andertei/Masteroppgave/README.md

Masteroppgave
=============

Masteroppgave for Anders Teigset
