andertei/Masteroppgave/CAD bilder/Ræl.odp

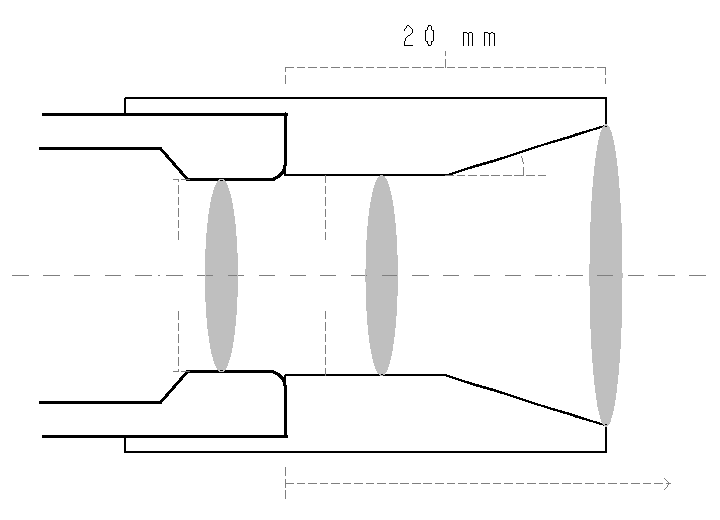
[picture p76: figure]
