andertei/Masteroppgave/Nyttige pdf-filer/kaldLuftSim.pdf

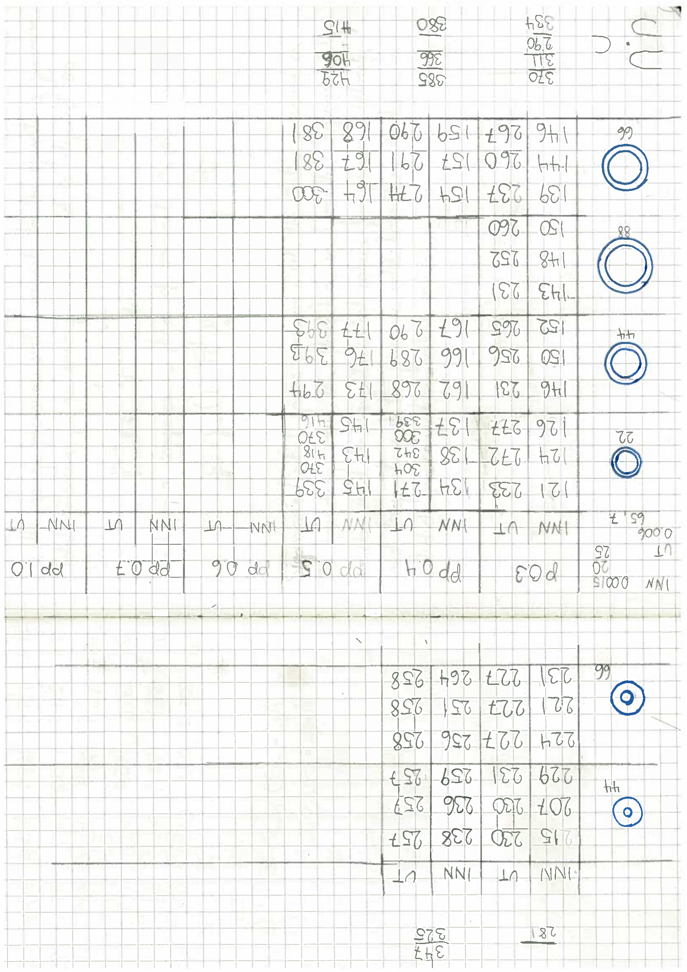
[picture p77: page 1]
