andertei/Masteroppgave/Bildesekvenser/selfblast/446_d6_579.png

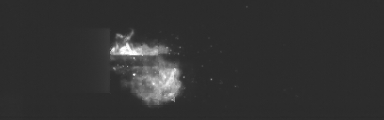
Bildesekvenser/selfblast/446_d6_579.png
