andertei/Masteroppgave/Bildesekvenser/selfblast/446_d6_580.png

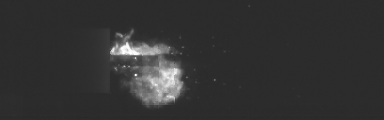
Bildesekvenser/selfblast/446_d6_580.png
