andertei/Masteroppgave/Bildesekvenser/selfblast/446_d6_589.png

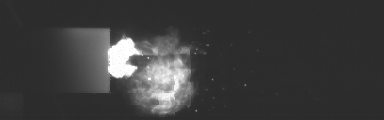
Bildesekvenser/selfblast/446_d6_589.png
