andertei/Masteroppgave/Bildesekvenser/selfblast/446_d6_592.png

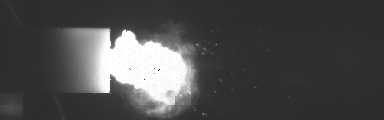
Bildesekvenser/selfblast/446_d6_592.png
