andertei/Masteroppgave/Bildesekvenser/selfblast/446_d6_594.png

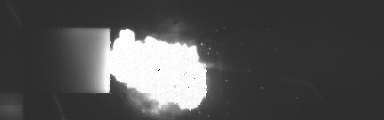
Bildesekvenser/selfblast/446_d6_594.png
