andertei/Masteroppgave/Bildesekvenser/selfblast/446_d6_596.png

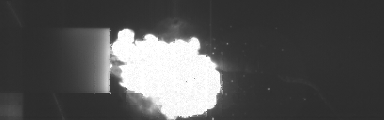
Bildesekvenser/selfblast/446_d6_596.png
