andertei/Masteroppgave/Bildesekvenser/selfblast/446_d6_607.png

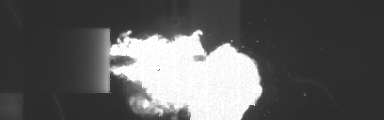
Bildesekvenser/selfblast/446_d6_607.png
