andertei/Masteroppgave/Bildesekvenser/selfblast/446_d6_608.png

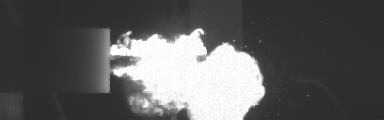
Bildesekvenser/selfblast/446_d6_608.png
