andertei/Masteroppgave/Bildesekvenser/selfblast/446_d6_611.png

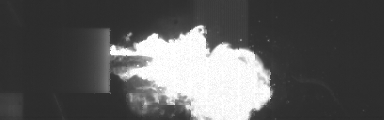
Bildesekvenser/selfblast/446_d6_611.png
