andertei/Masteroppgave/Bildesekvenser/selfblast/446_d6_622.png

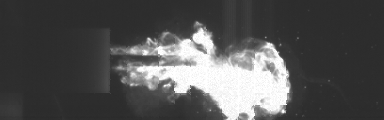
Bildesekvenser/selfblast/446_d6_622.png
