andertei/Masteroppgave/Bildesekvenser/selfblast/446_d6_626.png

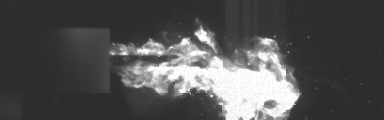
Bildesekvenser/selfblast/446_d6_626.png
