andertei/Masteroppgave/Bildesekvenser/selfblast/446_d6_628.png

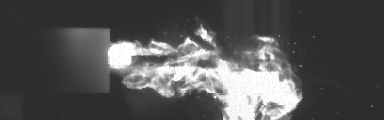
Bildesekvenser/selfblast/446_d6_628.png
