andertei/Masteroppgave/Bildesekvenser/selfblast/446_d6_629.png

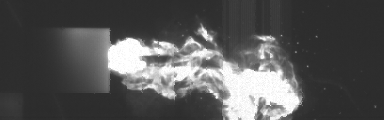
Bildesekvenser/selfblast/446_d6_629.png
