andertei/Masteroppgave/Bildesekvenser/selfblast/446_d6_630.png

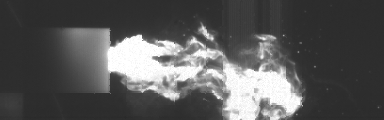
Bildesekvenser/selfblast/446_d6_630.png
