andertei/Masteroppgave/Bildesekvenser/selfblast/446_d6_632.png

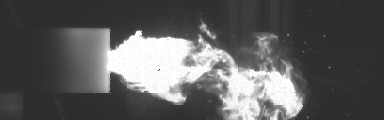
Bildesekvenser/selfblast/446_d6_632.png
