andertei/Masteroppgave/Bildesekvenser/selfblast/446_d6_634.png

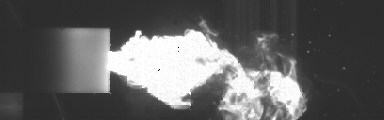
Bildesekvenser/selfblast/446_d6_634.png
