andertei/Masteroppgave/Bildesekvenser/selfblast/446_d6_635.png

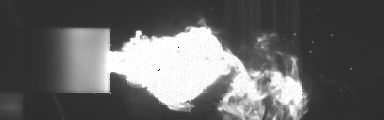
Bildesekvenser/selfblast/446_d6_635.png
