andertei/Masteroppgave/Bildesekvenser/selfblast/446_d6_637.png

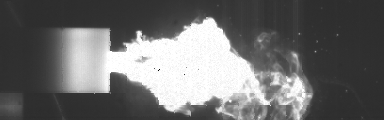
Bildesekvenser/selfblast/446_d6_637.png
