andertei/Masteroppgave/Bildesekvenser/selfblast/446_d6_638.png

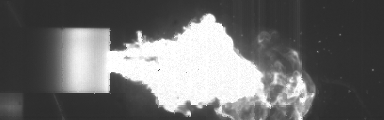
Bildesekvenser/selfblast/446_d6_638.png
