andertei/Masteroppgave/CAD bilder/ContactAndNozzleFunnelShape2.png

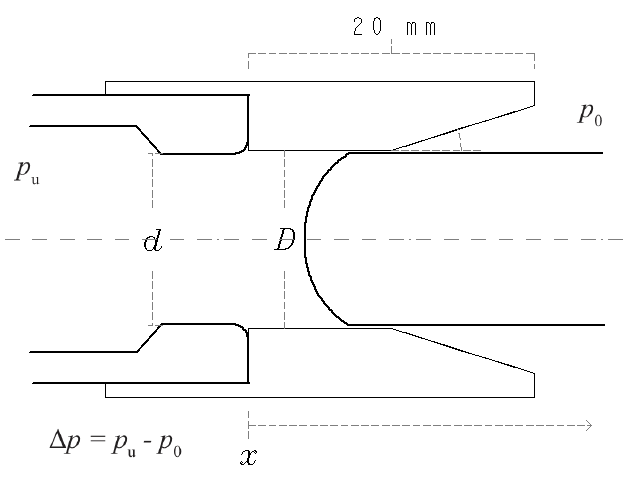
CAD bilder/ContactAndNozzleFunnelShape2.png
