andertei/Masteroppgave/CAD bilder/ContactAndNozzleFunnelShape3.png

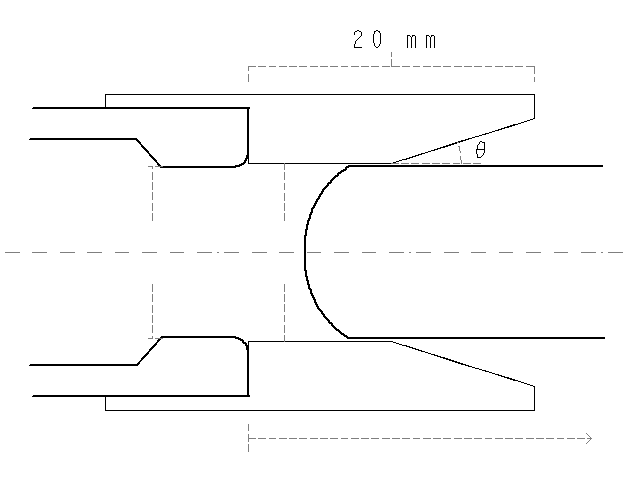
CAD bilder/ContactAndNozzleFunnelShape3.png
