andertei/Masteroppgave/CAD bilder/flowSketch/narrow_nozzle.png

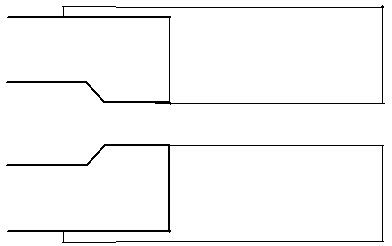
CAD bilder/flowSketch/narrow_nozzle.png
