andertei/Masteroppgave/Dokument/Bilder/Discussion/Breakdown_voltage.png

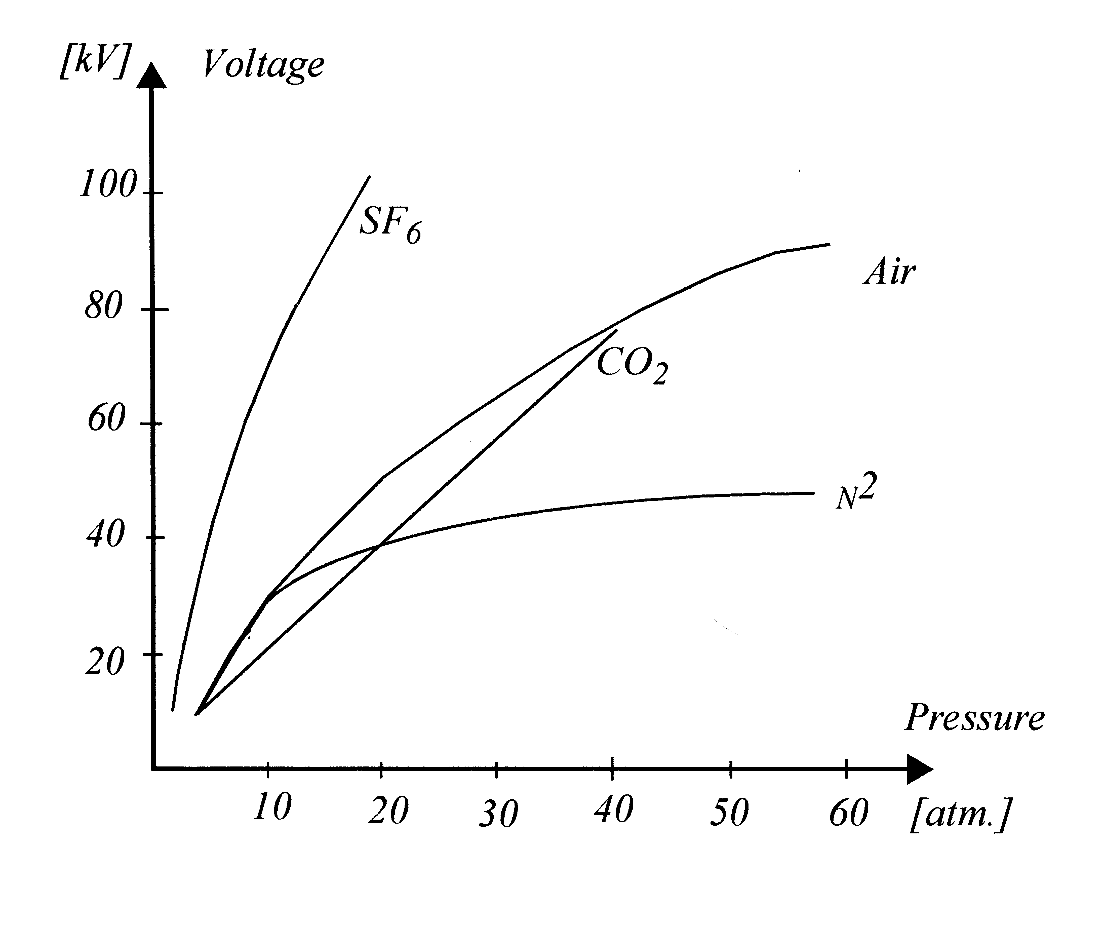
Dokument/Bilder/Discussion/Breakdown_voltage.png
