andertei/Masteroppgave/Dokument/Bilder/Discussion/conductSF6AndAIR.png

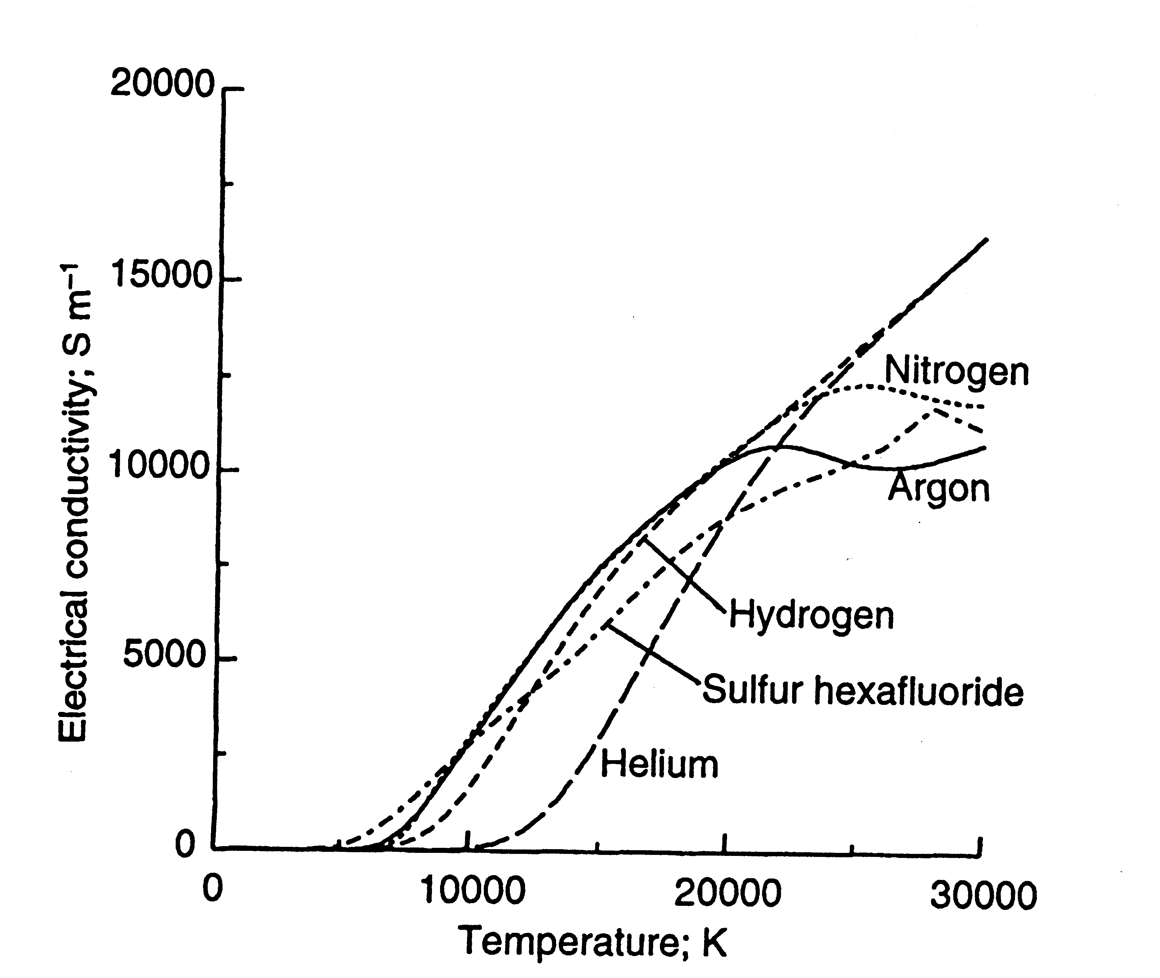
Dokument/Bilder/Discussion/conductSF6AndAIR.png
