andertei/Masteroppgave/Dokument/Bilder/Discussion/cone_D14.png

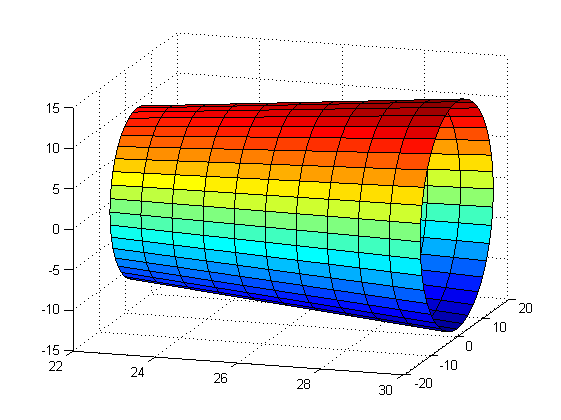
Dokument/Bilder/Discussion/cone_D14.png
