andertei/Masteroppgave/Dokument/Bilder/Discussion/cone_D16.png

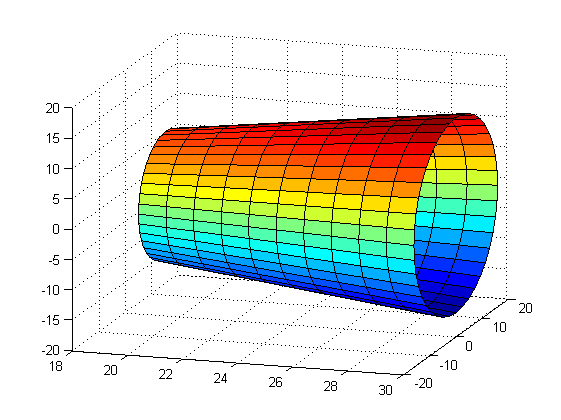
Dokument/Bilder/Discussion/cone_D16.png
