andertei/Masteroppgave/Dokument/Bilder/Discussion/d3_630_burn.png

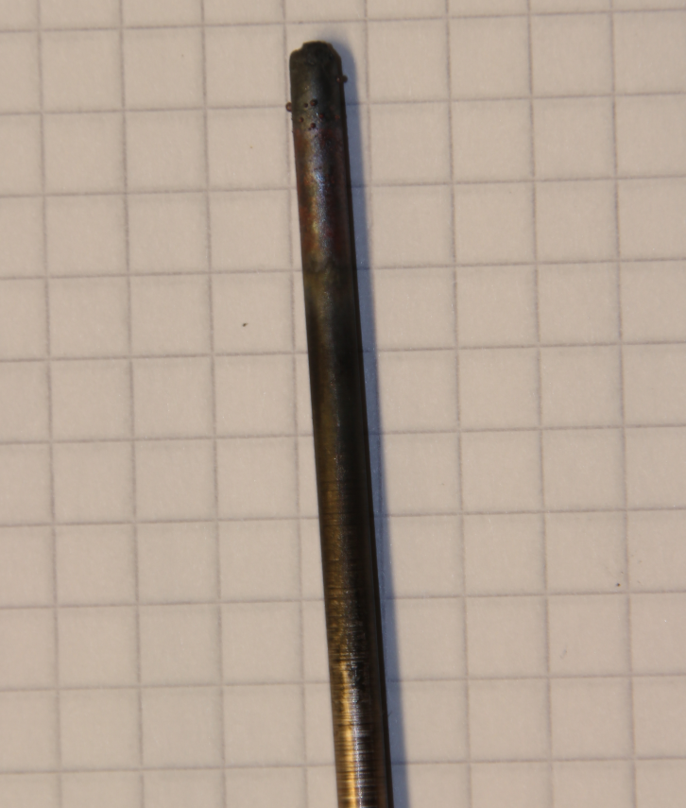
Dokument/Bilder/Discussion/d3_630_burn.png
