andertei/Masteroppgave/Dokument/Bilder/Discussion/d3_630_top_burn.png

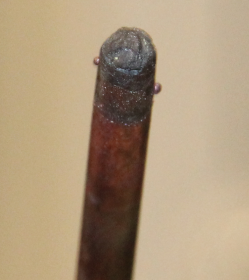
Dokument/Bilder/Discussion/d3_630_top_burn.png
