andertei/Masteroppgave/Dokument/Bilder/Discussion/d4_630and400_burn.png

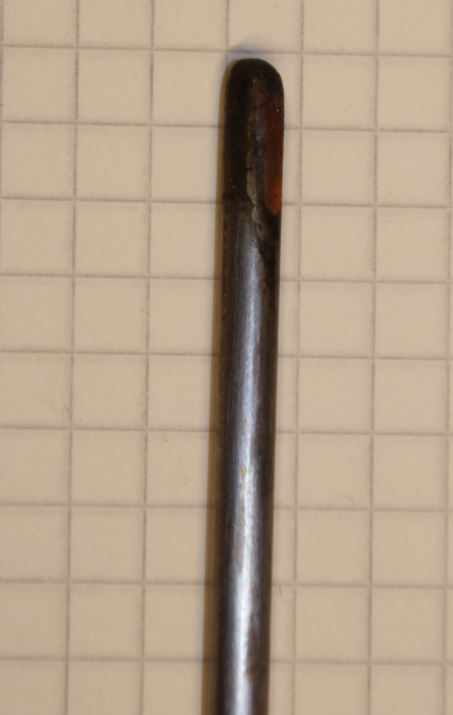
Dokument/Bilder/Discussion/d4_630and400_burn.png
