andertei/Masteroppgave/Dokument/Bilder/Discussion/d4_630and400_top_burn.png

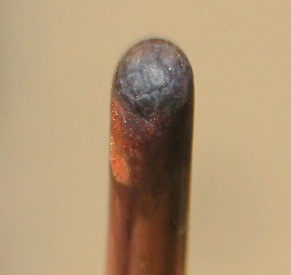
Dokument/Bilder/Discussion/d4_630and400_top_burn.png
