andertei/Masteroppgave/Dokument/Bilder/Discussion/femaleContacts4mmand3mm.png

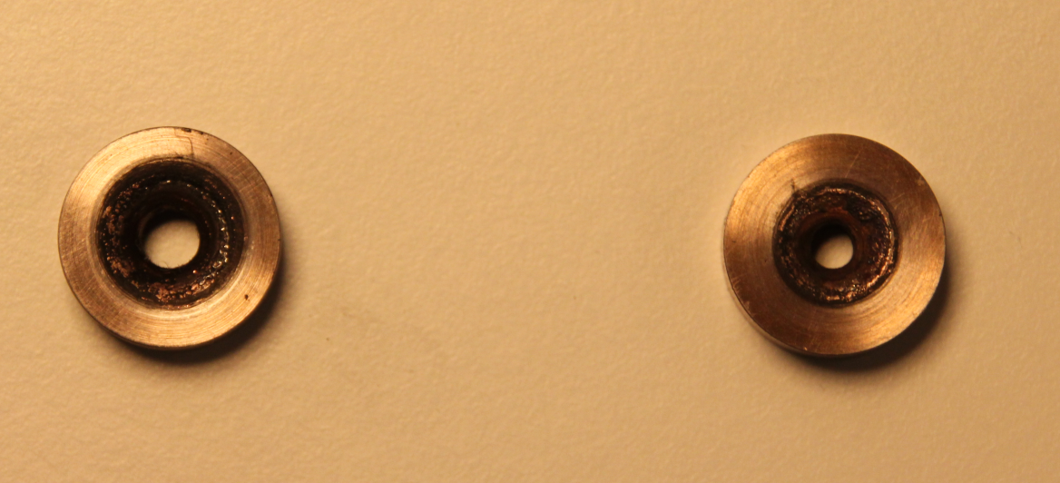
Dokument/Bilder/Discussion/femaleContacts4mmand3mm.png
