andertei/Masteroppgave/Dokument/Bilder/Discussion/paraDefine.png

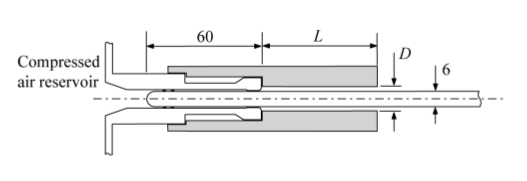
Dokument/Bilder/Discussion/paraDefine.png
