andertei/Masteroppgave/Dokument/Bilder/Discussion/percentSuccMVLBS.png

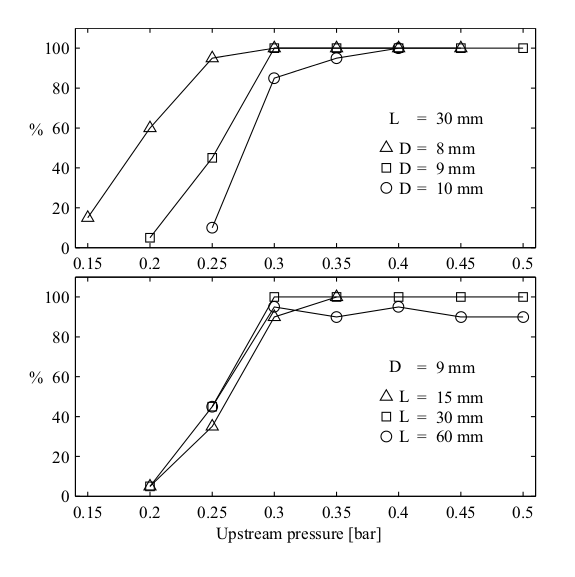
Dokument/Bilder/Discussion/percentSuccMVLBS.png
