andertei/Masteroppgave/Dokument/Bilder/Method/areaSetUp.png

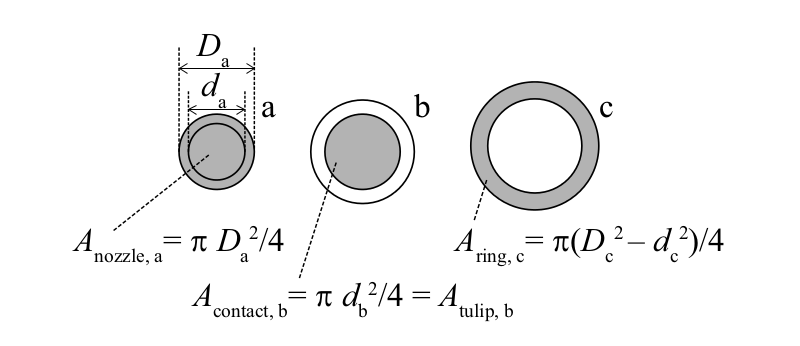
Dokument/Bilder/Method/areaSetUp.png
