andertei/Masteroppgave/Dokument/Bilder/Method/contactSetUpVmax2.png

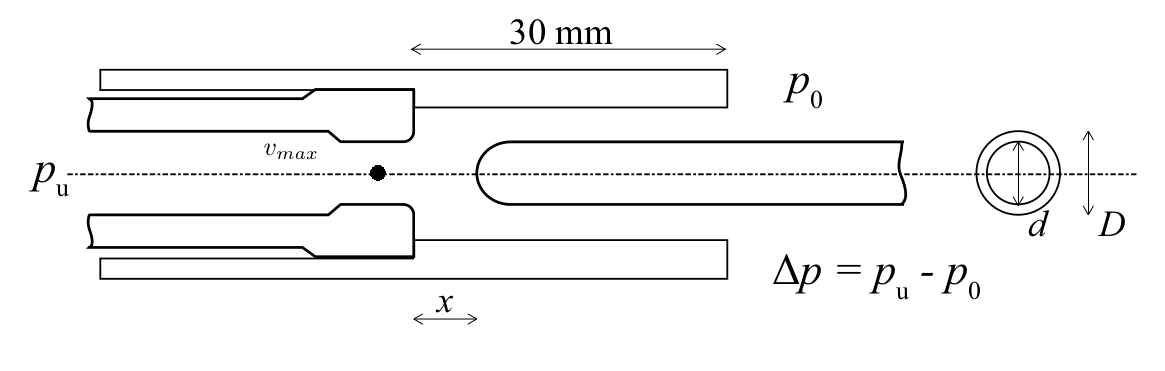
Dokument/Bilder/Method/contactSetUpVmax2.png
