andertei/Masteroppgave/Dokument/Bilder/Method/contactSetUpVmax3.png

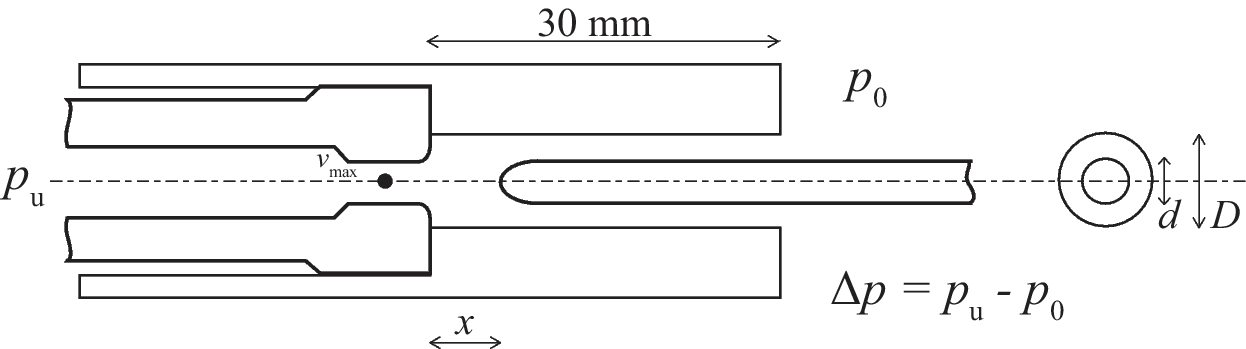
Dokument/Bilder/Method/contactSetUpVmax3.png
