andertei/Masteroppgave/Dokument/Bilder/Theory/arcingVoltagevzCurrent.png

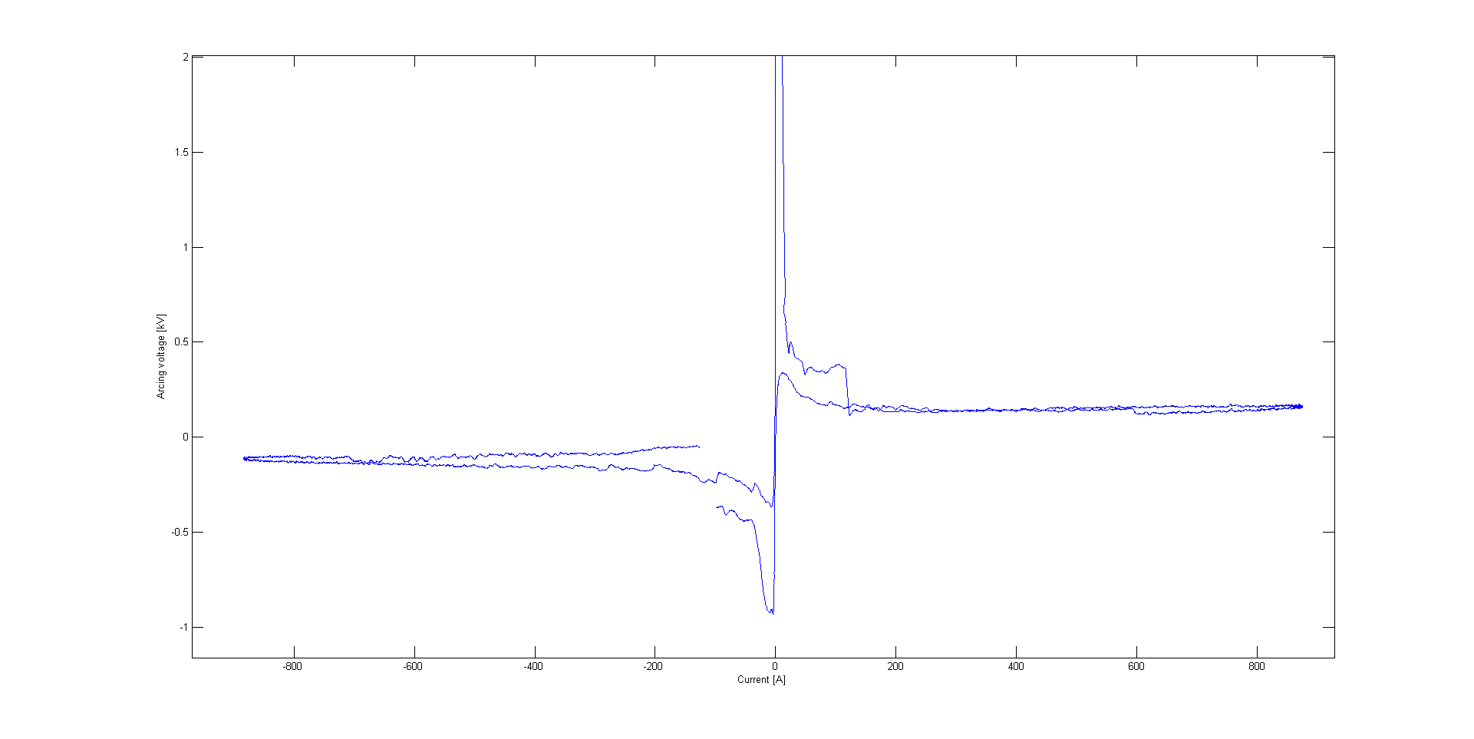
Dokument/Bilder/Theory/arcingVoltagevzCurrent.png
