andertei/Masteroppgave/Dokument/Bilder/Theory/CircutBreakPuff2.png

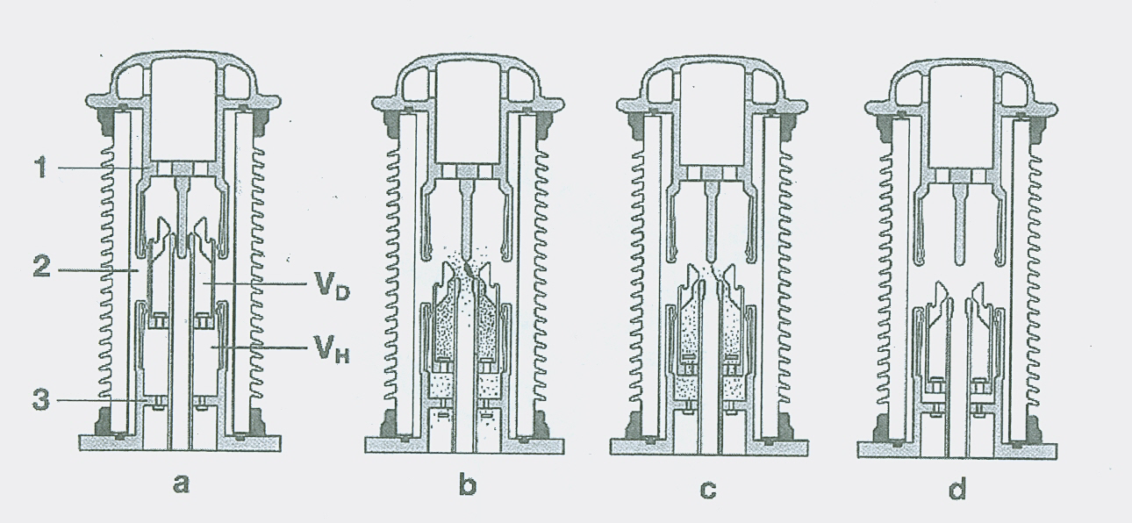
Dokument/Bilder/Theory/CircutBreakPuff2.png
