andertei/Masteroppgave/Dokument/Bilder/Theory/consentrationSF6.png

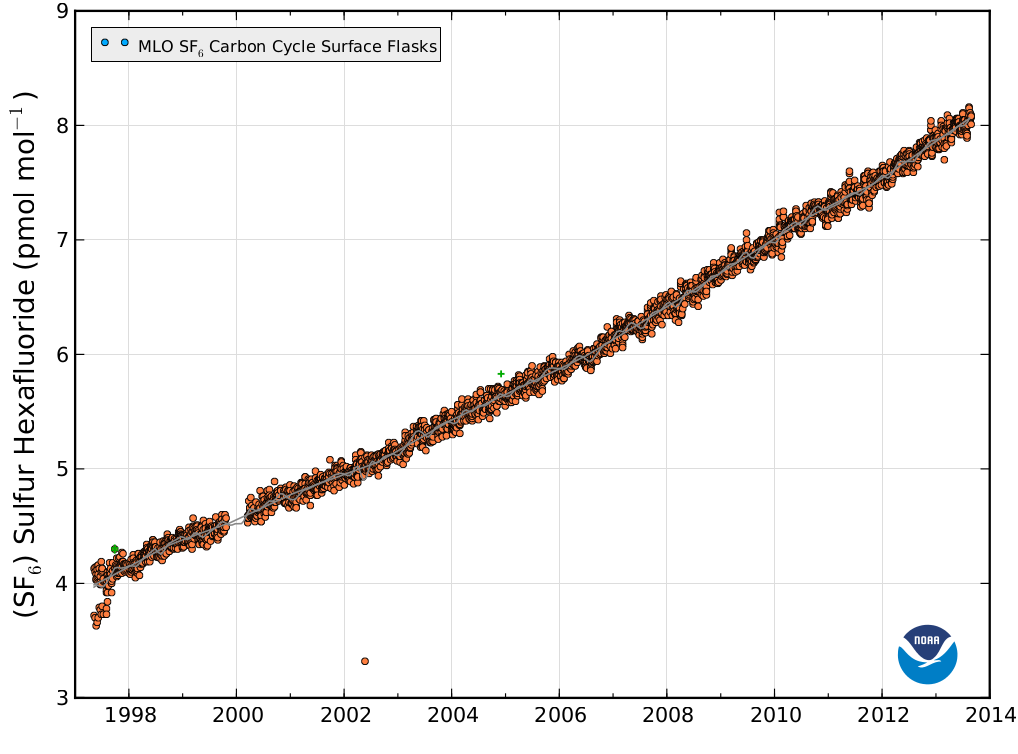
Dokument/Bilder/Theory/consentrationSF6.png
