andertei/Masteroppgave/Dokument/Bilder/Theory/differentGeometries.png

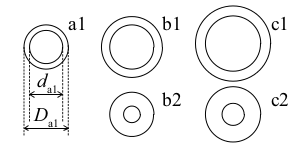
Dokument/Bilder/Theory/differentGeometries.png
