andertei/Masteroppgave/Dokument/Bilder/Theory/diffFreq2.png

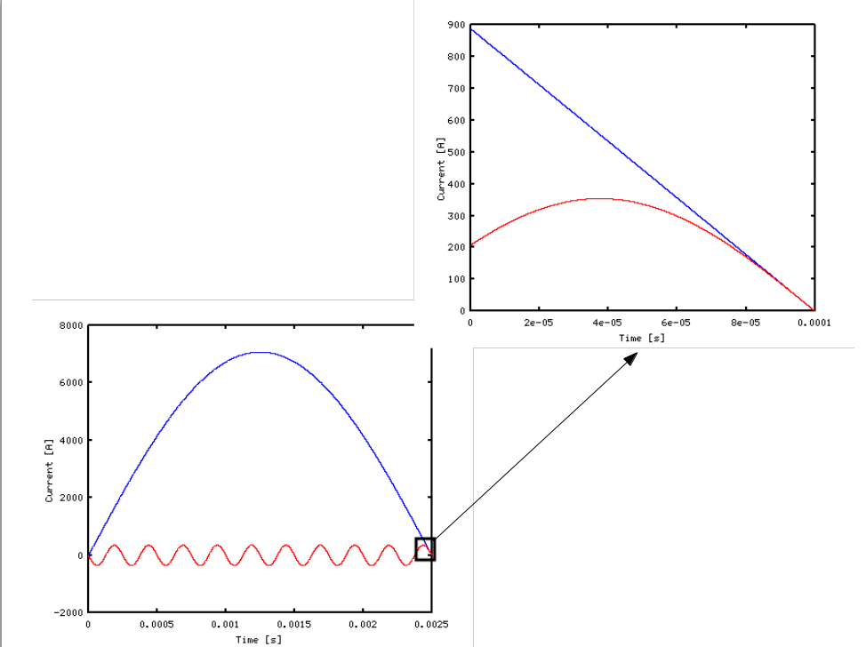
Dokument/Bilder/Theory/diffFreq2.png
