andertei/Masteroppgave/Dokument/Bilder/Theory/diffFreq.png

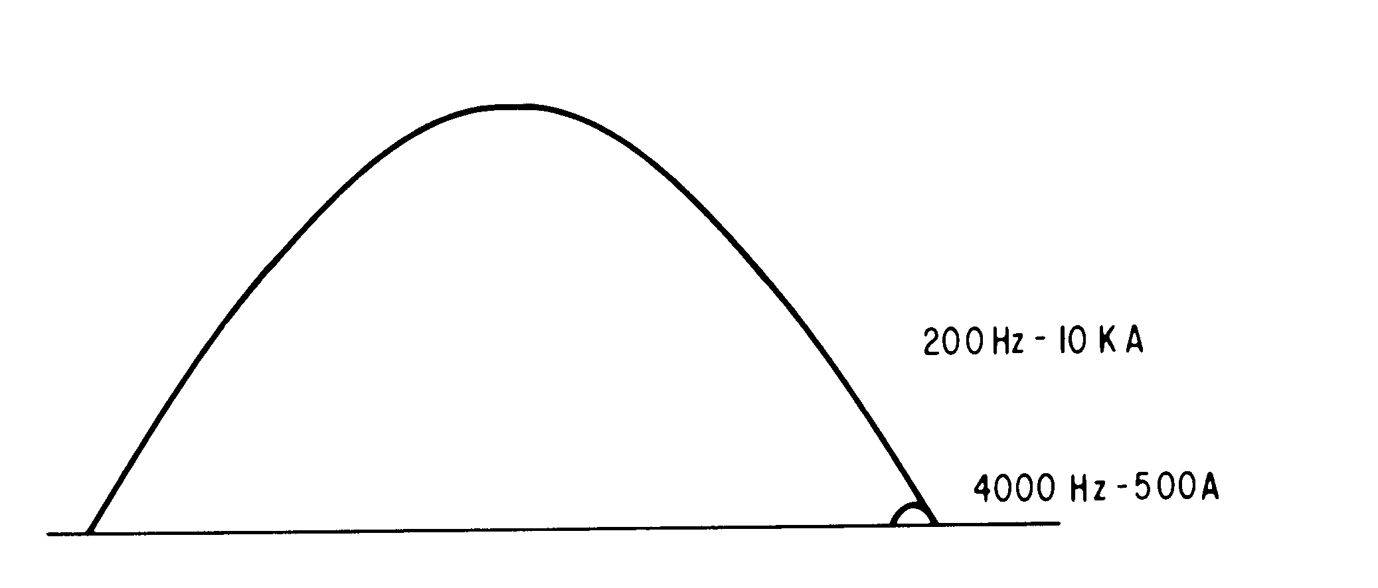
Dokument/Bilder/Theory/diffFreq.png
