andertei/Masteroppgave/Dokument/Bilder/Theory/emissionsSF6Norway.png

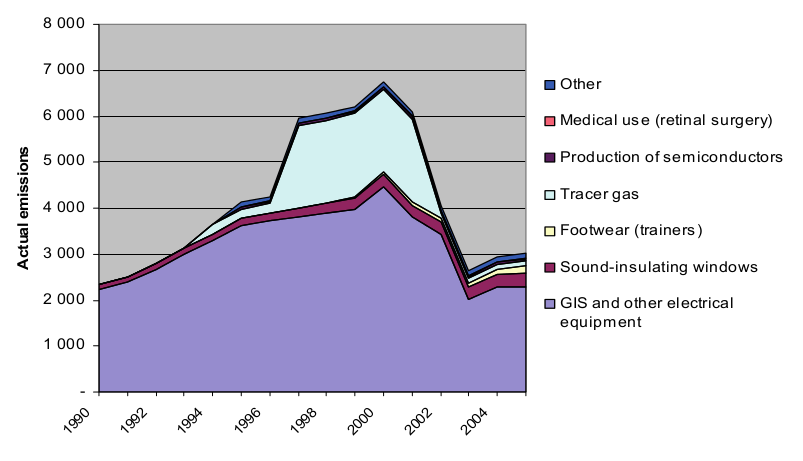
Dokument/Bilder/Theory/emissionsSF6Norway.png
