andertei/Masteroppgave/Dokument/Bilder/Theory/freq1.png

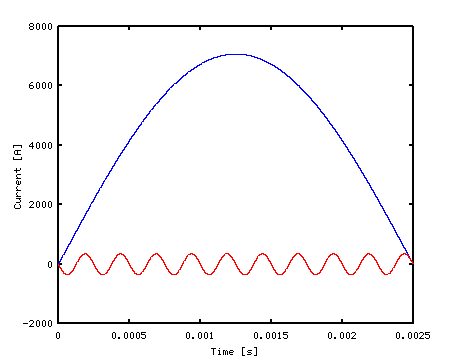
Dokument/Bilder/Theory/freq1.png
