andertei/Masteroppgave/Dokument/Bilder/Theory/freq2.png

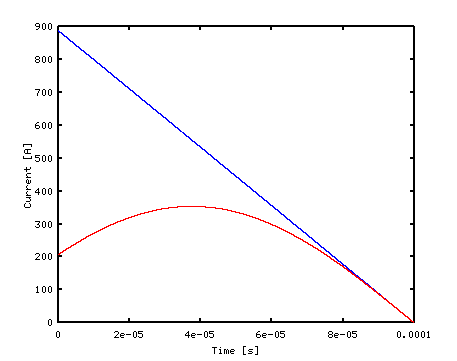
Dokument/Bilder/Theory/freq2.png
