andertei/Masteroppgave/Dokument/Bilder/Theory/freq3.png

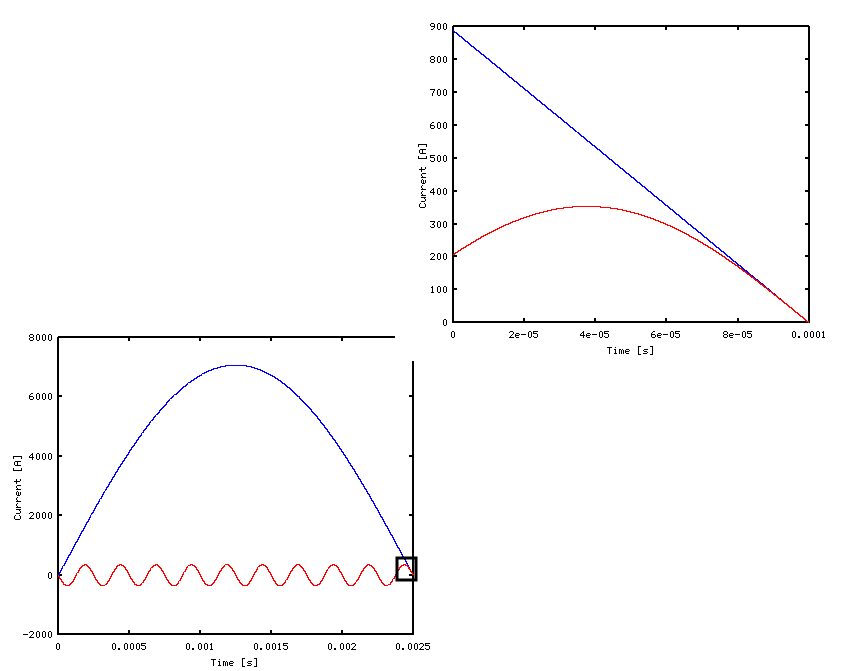
Dokument/Bilder/Theory/freq3.png
