andertei/Masteroppgave/Dokument/Bilder/Theory/kontaktoversiktAnders.png

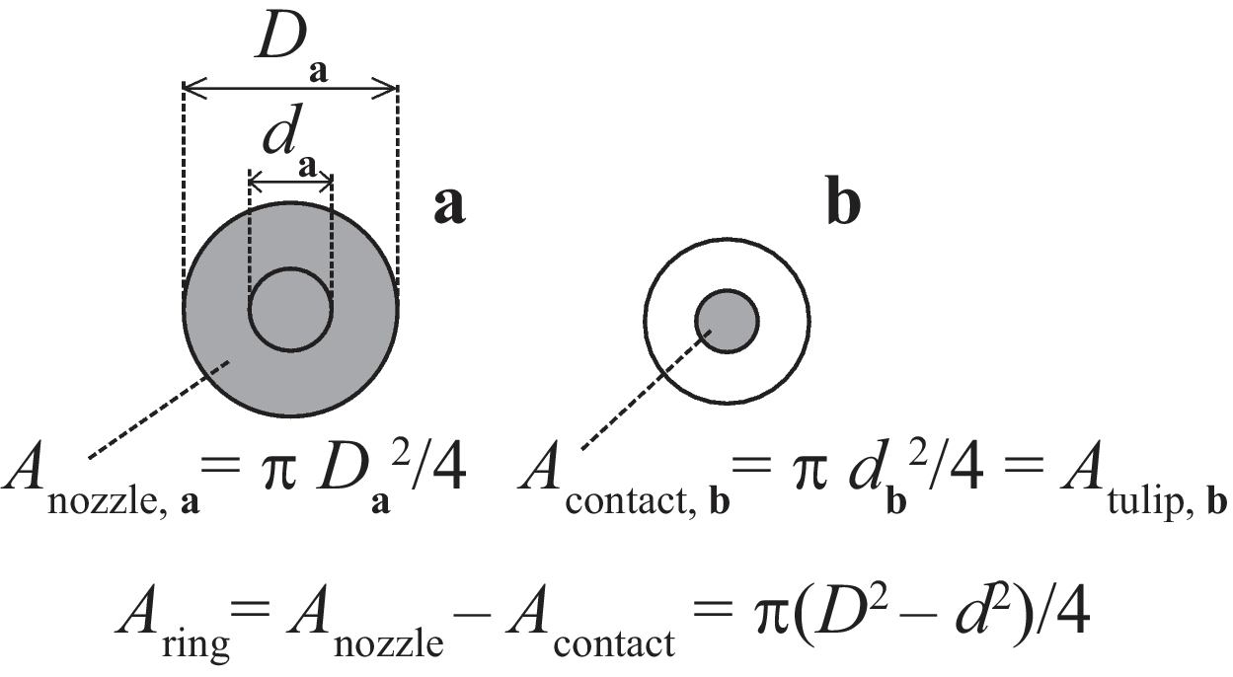
Dokument/Bilder/Theory/kontaktoversiktAnders.png
