andertei/Masteroppgave/Dokument/Bilder/Theory/particleDensSF6.png

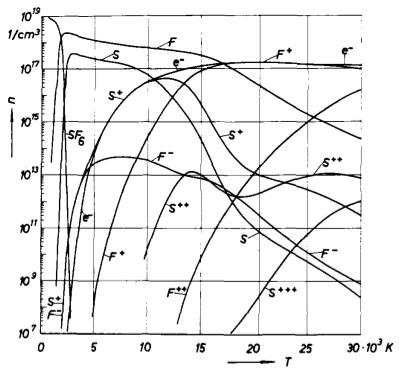
Dokument/Bilder/Theory/particleDensSF6.png
