andertei/Masteroppgave/Dokument/Bilder/Theory/SF6Conduct.png

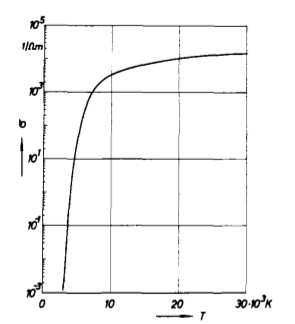
Dokument/Bilder/Theory/SF6Conduct.png
