andertei/Masteroppgave/CAD bilder/#contactGeometry_areaDeff.dxf

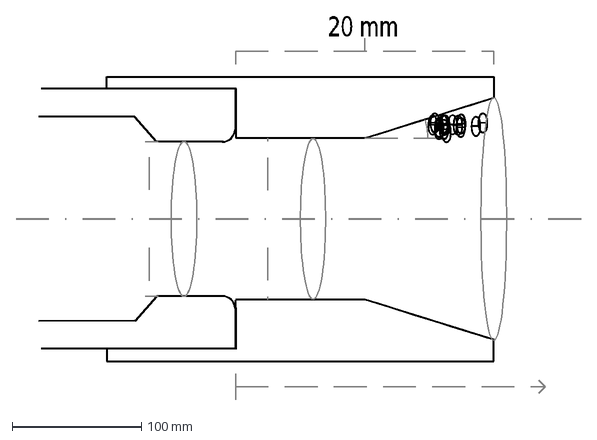
[picture p127: CAD file, 2014-02-04]
CAD bilder/#contactGeometry_areaDeff.dxf
θ
20 mm
