andertei/Masteroppgave/CAD bilder/bellow/#bellow.dxf

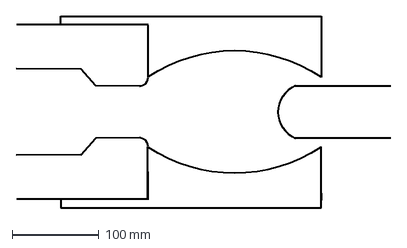
[picture p128: CAD file, 2014-04-25]
CAD bilder/bellow/#bellow.dxf
431.6 x 220.7 mm
