andertei/Masteroppgave/CAD bilder/flowSketch/flowSketch_wide.dxf

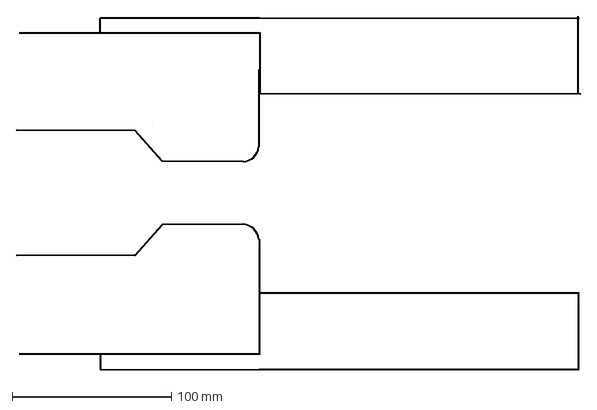
[picture p129: CAD file, 2014-04-24]
CAD bilder/flowSketch/flowSketch_wide.dxf
354.3 x 221.6 mm
