andertei/Masteroppgave/CAD bilder/contactGeometry2.dxf

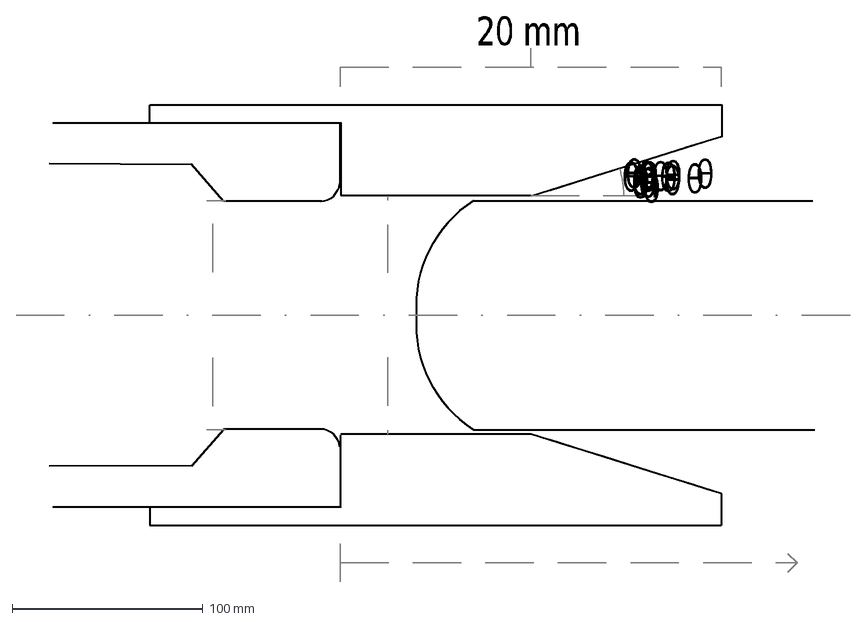
[picture p130: CAD file, 2014-02-03]
CAD bilder/contactGeometry2.dxf
θ
20 mm
q
