andertei/Masteroppgave/CAD bilder/flowSketch/flowSketch_narrow.dxf

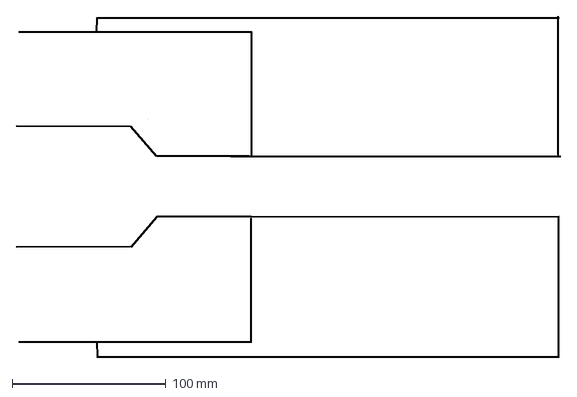
[picture p131: CAD file, 2014-04-24]
CAD bilder/flowSketch/flowSketch_narrow.dxf
354.3 x 221.6 mm
