andertei/Masteroppgave/CAD bilder/##contactGeometry.dxf

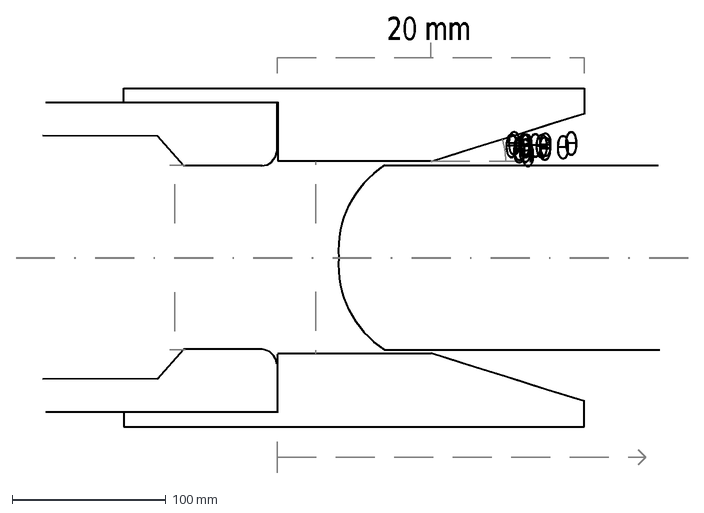
[picture p132: CAD file, 2014-02-03]
CAD bilder/##contactGeometry.dxf
θ
20 mm
q
