andertei/Masteroppgave/CAD bilder/flowSketch/#flowSketch.dxf

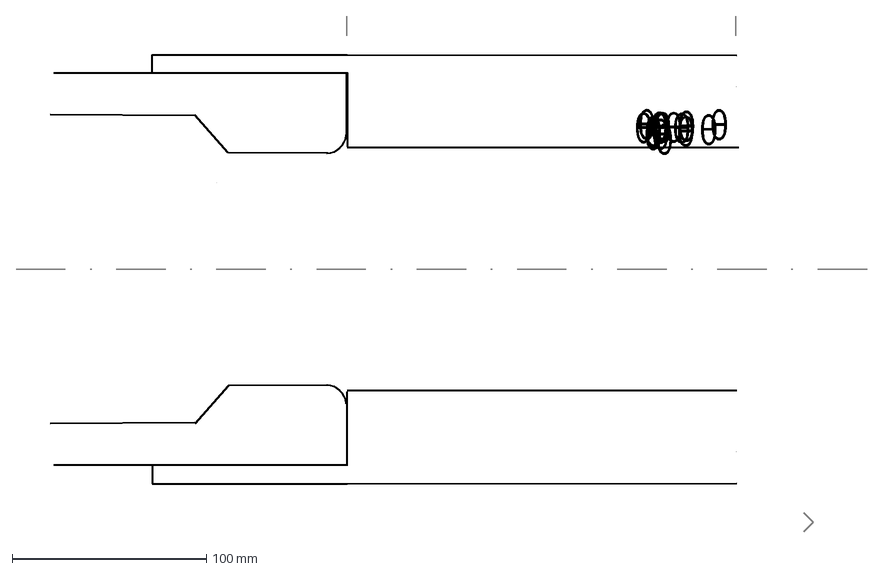
[picture p133: CAD file, 2014-04-24]
CAD bilder/flowSketch/#flowSketch.dxf
θ
