andertei/Masteroppgave/(list of files, cad)

Other CAD files:
CAD bilder/#contactGeometry.dxf
CAD bilder/bellow/bellow.dxf
CAD bilder/contactGeometry_areaDeff.dxf
CAD bilder/flowSketch/flowSketch.dxf
