andertei/Masteroppgave/Resultater/excel-plot/630Ad7.1.xlsx

Sheet: 630AgeoC
Pressure | Position at first CZ | Position at secound CZ | Succsess
0.4 | 55 |  | 1
0.4 | 42 |  | 1 |  | Test less than 35 are dicarded due to transcation effects from the nozzle |  |  |  |  | Antall brytninger som gikk for 35+ for statistikk
0.4 | 47 |  | 1 |  | 630 A |  |  |  |  | 1
0.4 | 53 |  | 1 | Pressure | Amount of successful | Successrate | Number of tests | Total Succsessrate |  | 1
0.4 | 51 |  | 1 | 0.2 | 0 | 0 | 5 |  |  | 1
0.35 | 36 | 91 | 0 | 0.25 | 0 | 0 | 5 |  |  | 1
0.35 | 42 |  | 1 | 0.3 | 8 | 80 | 10 |  |  | 1
0.35 | 54 |  | 1 | 0.35 | 4 | 80 | 5 |  |  | 1
0.35 | 43 |  | 1 | 0.4 | 5 | 100 | 5 |  |  | 1
0.35 | 45 |  | 1 |  |  |  |  |  | 15 | 1
0.3 | 49 |  | 1 |  |  |  |  |  |  | 1
0.3 | 42 |  | 1 |  |  |  |  |  |  | 0
0.3 | 48 |  | 1 |  |  |  |  |  |  | 0
0.3 | 35 | 83 | 1 |  |  |  |  |  | 72 | 0
0.3 | 40 |  | 1 |  |  |  |  |  |  | 0
0.3 | 35 |  | 1 |  |  |  |  |  |  | 1
0.3 | 37 |  | 1 |  |  |  |  |  |  | 1
0.3 | 43 |  | 1 |  |  |  |  |  |  | 1
0.3 | 42 | 59 | 0 |  |  |  |  |  |  | 1
0.3 | 50 | 108 | 0 |  |  |  |  |  |  | 1
0.2 | 36 | 90 | 0 |  |  |  |  |  |  | 1
0.2 | 54 | 102 | 0 |  |  |  |  |  |  | 1
0.2 | 43 | 90 | 0 |  |  |  |  |  |  | 0
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
