andertei/Masteroppgave/Resultater/excel-plot/630Ad6.0.xlsx

Sheet: 630Adata
Pressure | Position at first CZ | Position at secound CZ | Succsess
0.3 | 39 |  | 1
0.3 | 26 |  | 1
0.3 | 19 |  | 1
0.3 | 49 |  | 1 |  | 630 A
0.3 | 21 |  | 1 | Pressure | Amount of successful | Successrate | Number of tests | Number of success funnle | Succsesrate funnle | Number of success outside | Successrate outside
0.3 | 19 |  | 1 | 0.15 | 0 | 0 | 10 | 0 | 0 | 0 | 0
0.3 | 47 |  | 1 | 0.2 | 6 | 60 | 10 | 2 | 40 | 4 | 80
0.3 | 15 |  | 1 | 0.25 | 9 | 90 | 10 | 3.97 | 79.4 | 4 | 80
0.3 | 11 |  | 1 | 0.3 | 10 | 100 | 10 | 4.97 | 99.4 | 5 | 100
0.3 | 11 |  | 1
0.25 | 26 |  | 1
0.25 | 23 |  | 1
0.25 | 16 |  | 1
0.25 | 55 |  | 1 | 20+ |  | geoA630 |  |  | 10+
0.25 | 26 | 81 | 1 | 0.3 | 1 |  |  | 0.3 | 1
0.25 | 36 |  | 1 | 0.3 | 1 |  |  | 0.3 | 1
0.25 | 15 |  | 1 | 0.3 | 1 |  |  | 0.3 | 1
0.25 | 15 | 70 | 0 | 0.3 | 1 |  |  | 0.3 | 1
0.25 | 15 |  | 1 | 0.3 | 1 |  |  | 0.3 | 1
0.25 | 17 |  | 1 | 0.3 | 1 |  |  | 0.3 | 1
0.2 | 16 | 68 | 0 | 0.3 | 1 |  |  | 0.3 | 1
0.2 | 17 |  | 1 | 0.3 | 1 |  |  | 0.3 | 1
0.2 | 14 | 69 | 0 | 0.3 | 1 |  |  | 0.3 | 1
0.2 | 11 | 65 | 0 | 0.3 | 1 | 11 |  | 0.3 | 1
0.2 | 44 |  | 1 | 0.3 | 1 | success rate= | 100 | 0.3 | 1 | antall: 18
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
