andertei/Masteroppgave/Dokument/Bilder/Discussion/ninaResults.png

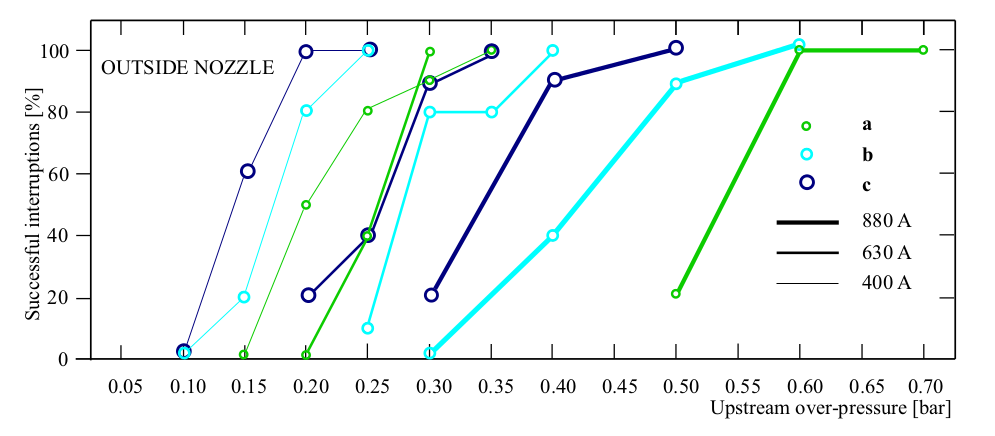
Dokument/Bilder/Discussion/ninaResults.png
