andertei/Masteroppgave/Dokument/Bilder/Discussion/testResultsNinaInside.png

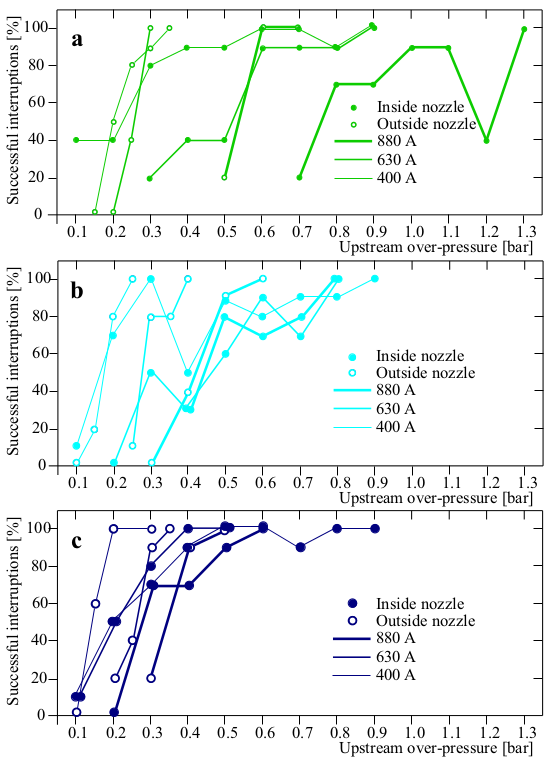
Dokument/Bilder/Discussion/testResultsNinaInside.png
