andertei/Masteroppgave/Dokument/Bilder/Results/arcingVoltage400Ad4.png

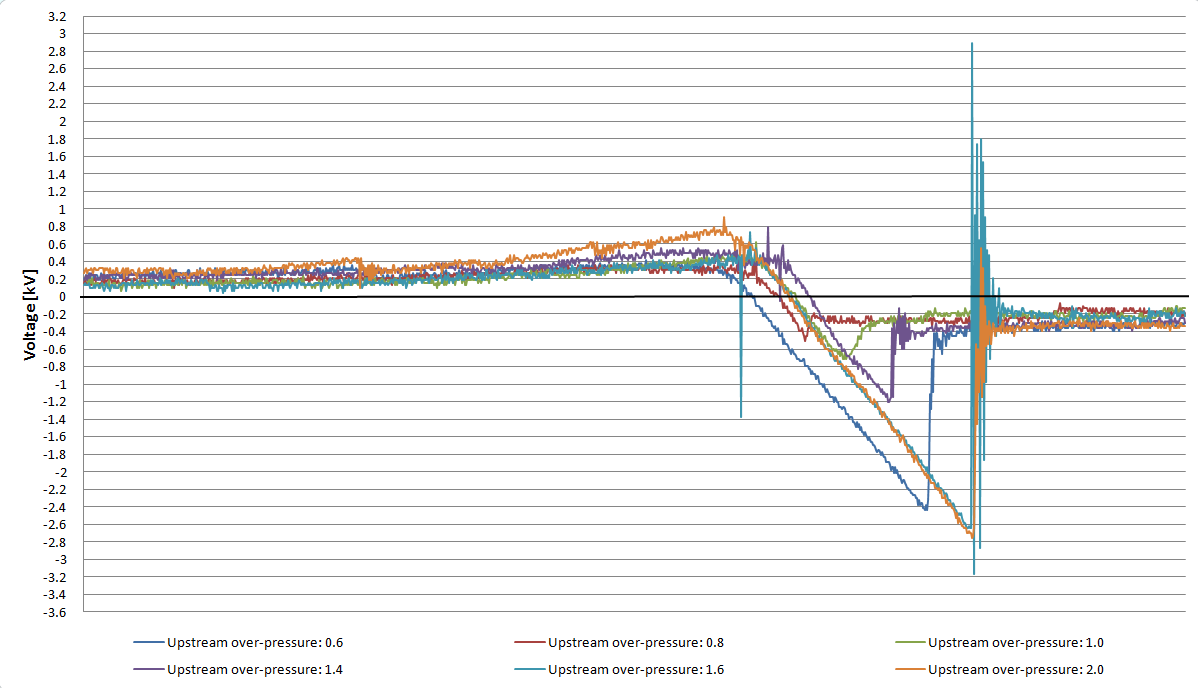
Dokument/Bilder/Results/arcingVoltage400Ad4.png
