andertei/Masteroppgave/Dokument/Bilder/Results/arcingVoltage630Ad4.png

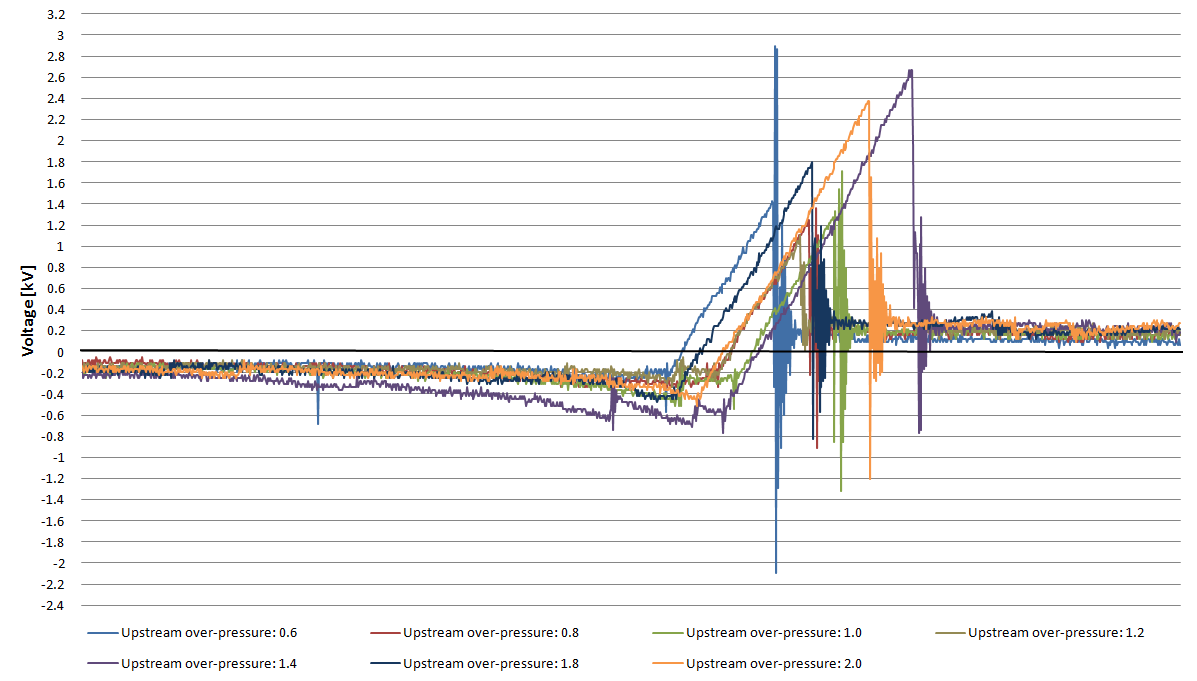
Dokument/Bilder/Results/arcingVoltage630Ad4.png
