andertei/Masteroppgave/Dokument/Bilder/Results/ATPdraw_lab.png

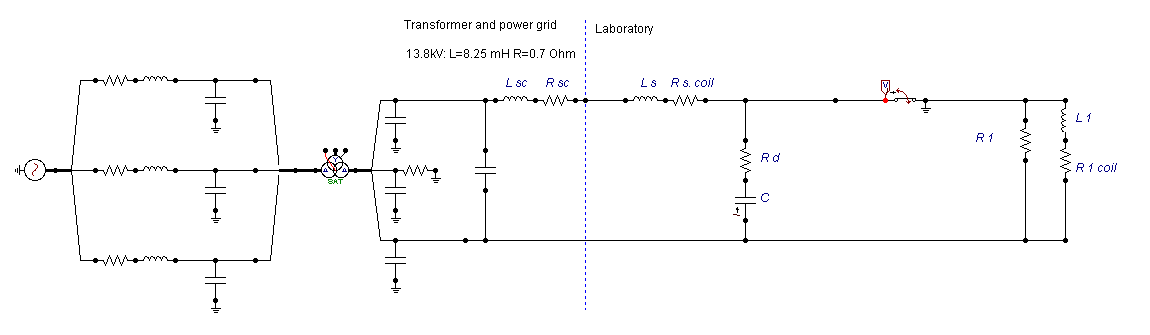
Dokument/Bilder/Results/ATPdraw_lab.png
