andertei/Masteroppgave/Dokument/Bilder/Results/ATPdraw_lab_2.png

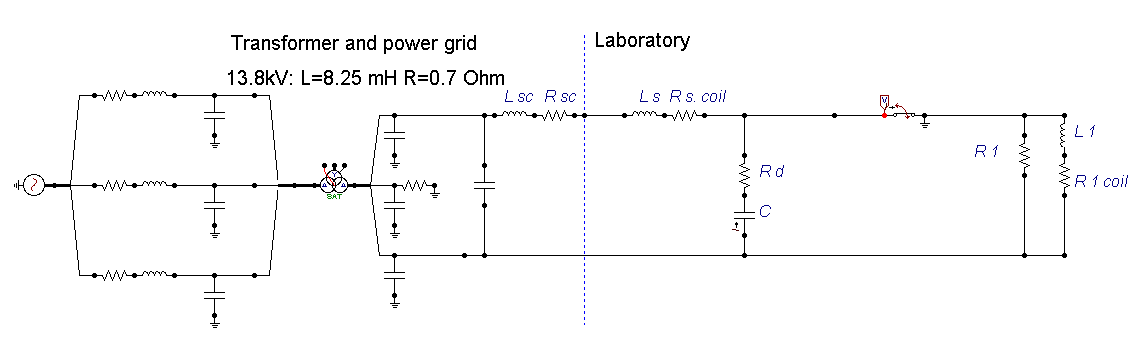
Dokument/Bilder/Results/ATPdraw_lab_2.png
