andertei/Masteroppgave/Dokument/Bilder/Results/ATPdraw_Over_CurrentandVoltage.png

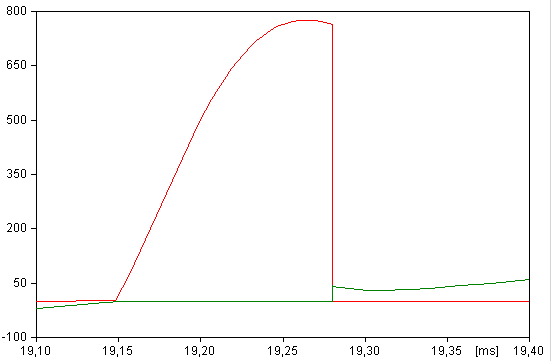
Dokument/Bilder/Results/ATPdraw_Over_CurrentandVoltage.png
