andertei/Masteroppgave/Dokument/Bilder/Results/ATPdraw_Over_CurrentandVoltage_2.png

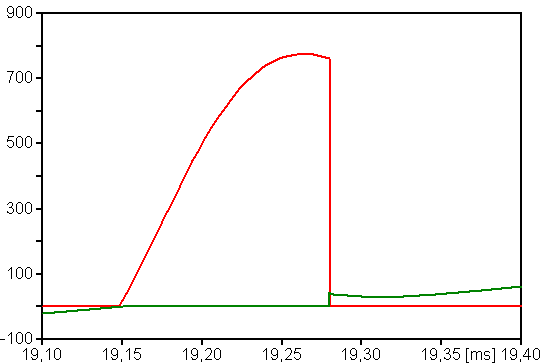
Dokument/Bilder/Results/ATPdraw_Over_CurrentandVoltage_2.png
