andertei/Masteroppgave/Dokument/Bilder/Results/ATPdraw_Over_CurrentandVoltage_label.png

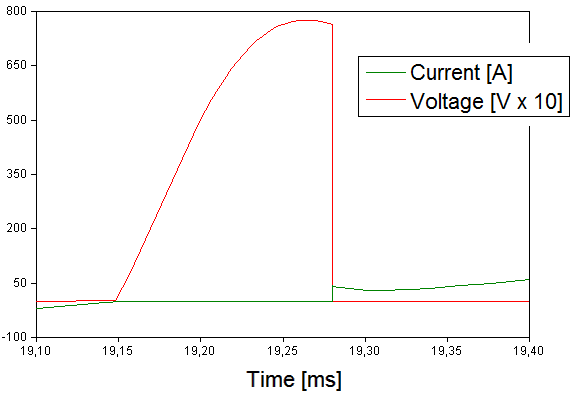
Dokument/Bilder/Results/ATPdraw_Over_CurrentandVoltage_label.png
