andertei/Masteroppgave/Dokument/Bilder/Results/ATPdraw_ZOOM_CurrentandVoltage.png

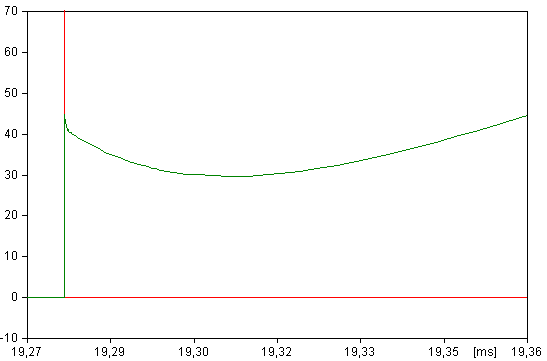
Dokument/Bilder/Results/ATPdraw_ZOOM_CurrentandVoltage.png
