andertei/Masteroppgave/Dokument/Bilder/Results/ATPdraw_ZOOM_CurrentandVoltage_2.png

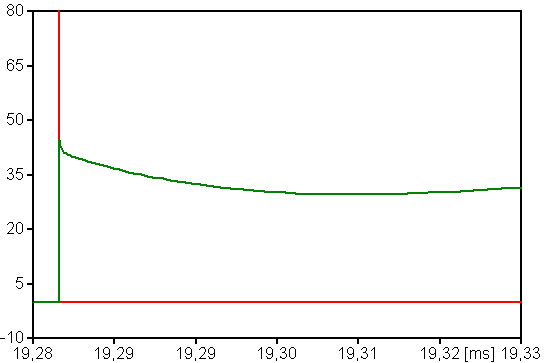
Dokument/Bilder/Results/ATPdraw_ZOOM_CurrentandVoltage_2.png
