andertei/Masteroppgave/Dokument/Bilder/Results/ATPdraw_ZOOM_CurrentandVoltage_label.png

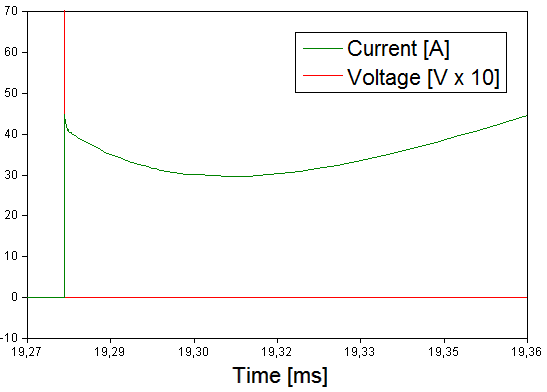
Dokument/Bilder/Results/ATPdraw_ZOOM_CurrentandVoltage_label.png
