andertei/Masteroppgave/Dokument/Bilder/Results/bellow1.png

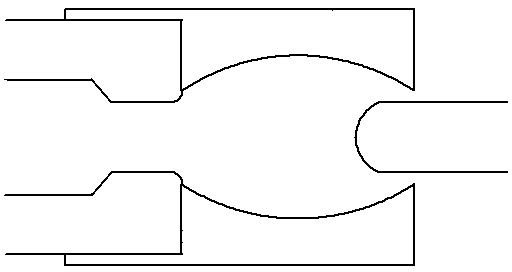
Dokument/Bilder/Results/bellow1.png
