andertei/Masteroppgave/Dokument/Bilder/Results/bellow.png

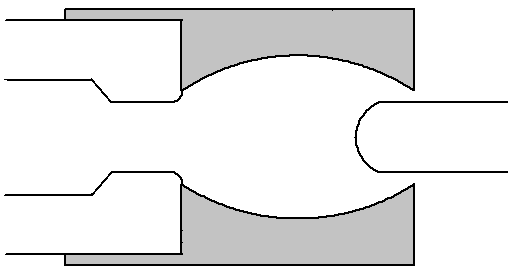
Dokument/Bilder/Results/bellow.png
