andertei/Masteroppgave/Dokument/Bilder/Results/compAllCylin.PNG

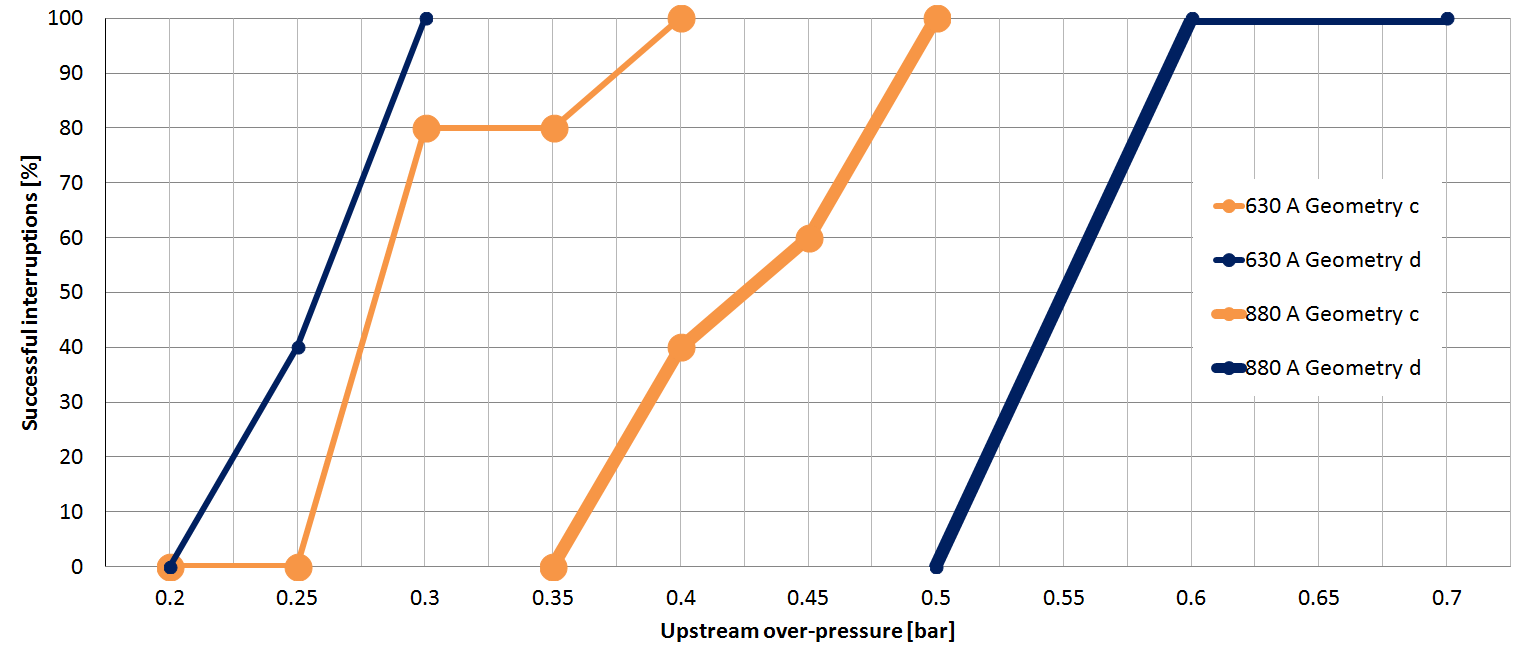
Dokument/Bilder/Results/compAllCylin.PNG
