andertei/Masteroppgave/Dokument/Bilder/Results/compAllFunnel.PNG

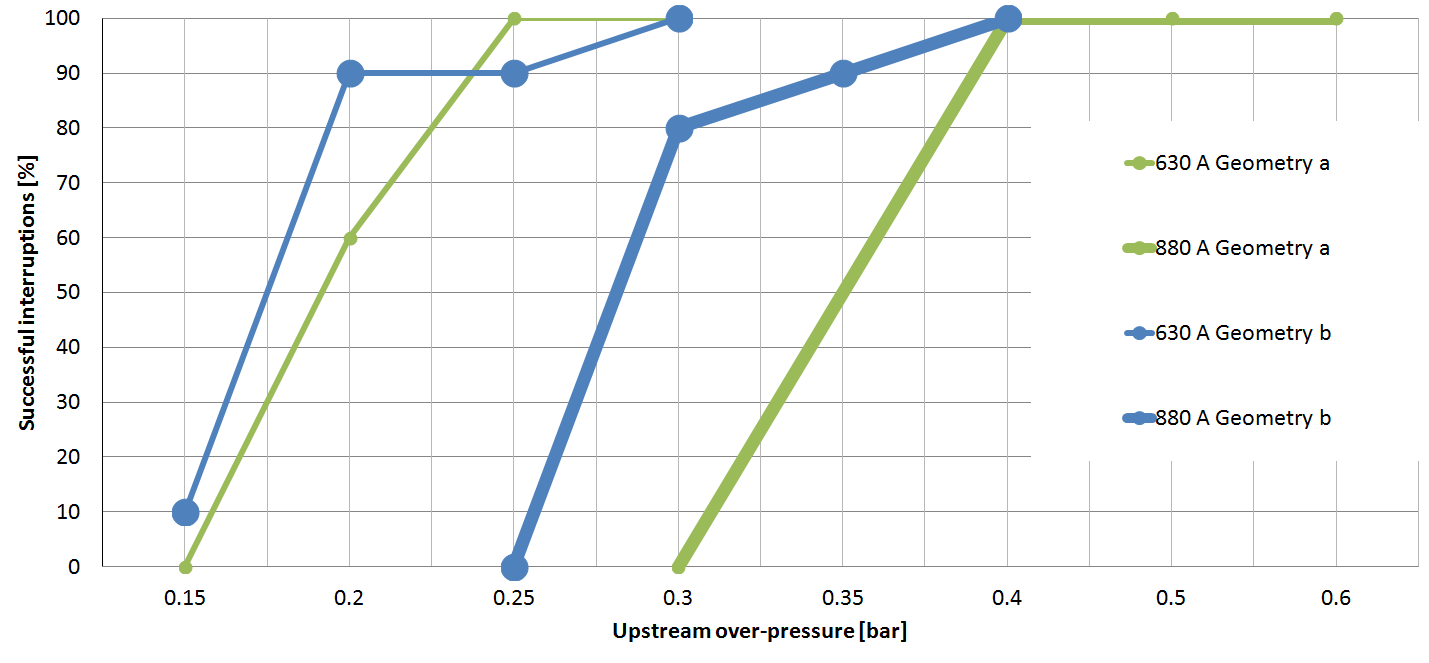
Dokument/Bilder/Results/compAllFunnel.PNG
