andertei/Masteroppgave/Dokument/Bilder/Results/compAllFunnel_riktig.PNG

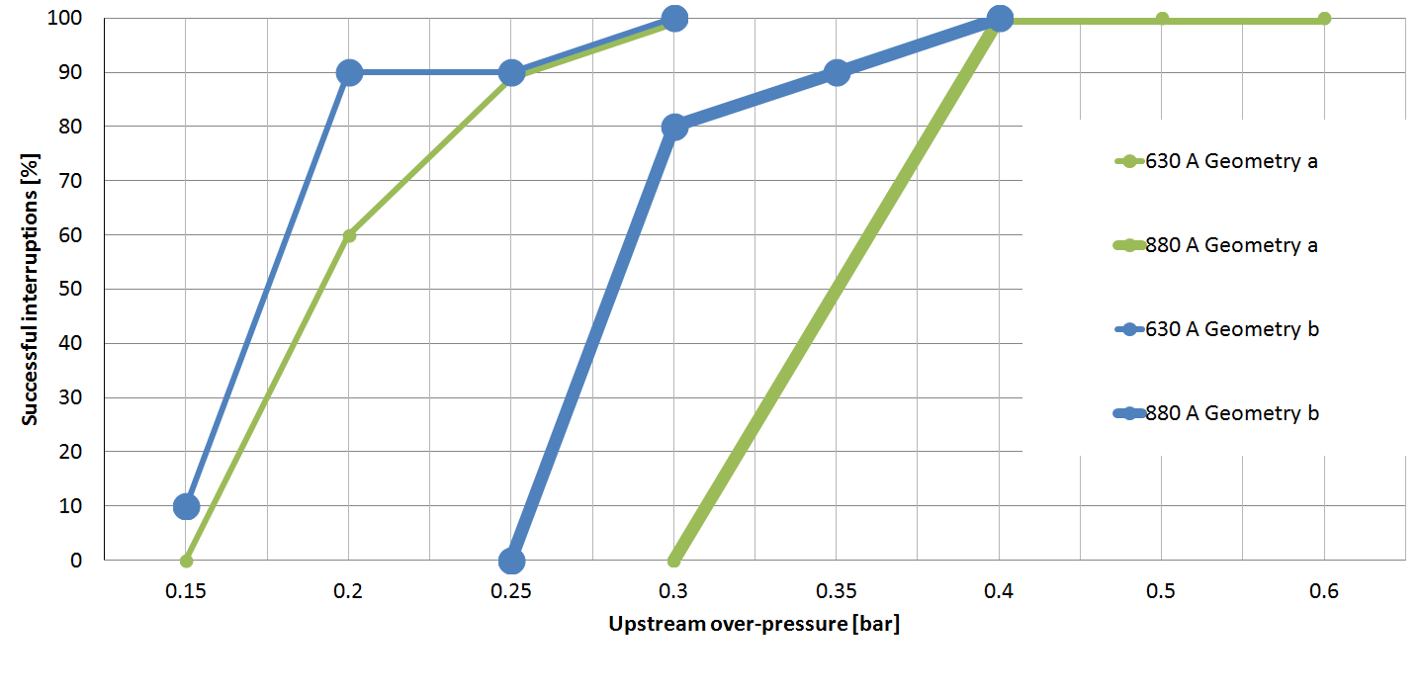
Dokument/Bilder/Results/compAllFunnel_riktig.PNG
