andertei/Masteroppgave/Dokument/Bilder/Results/DRplot.png

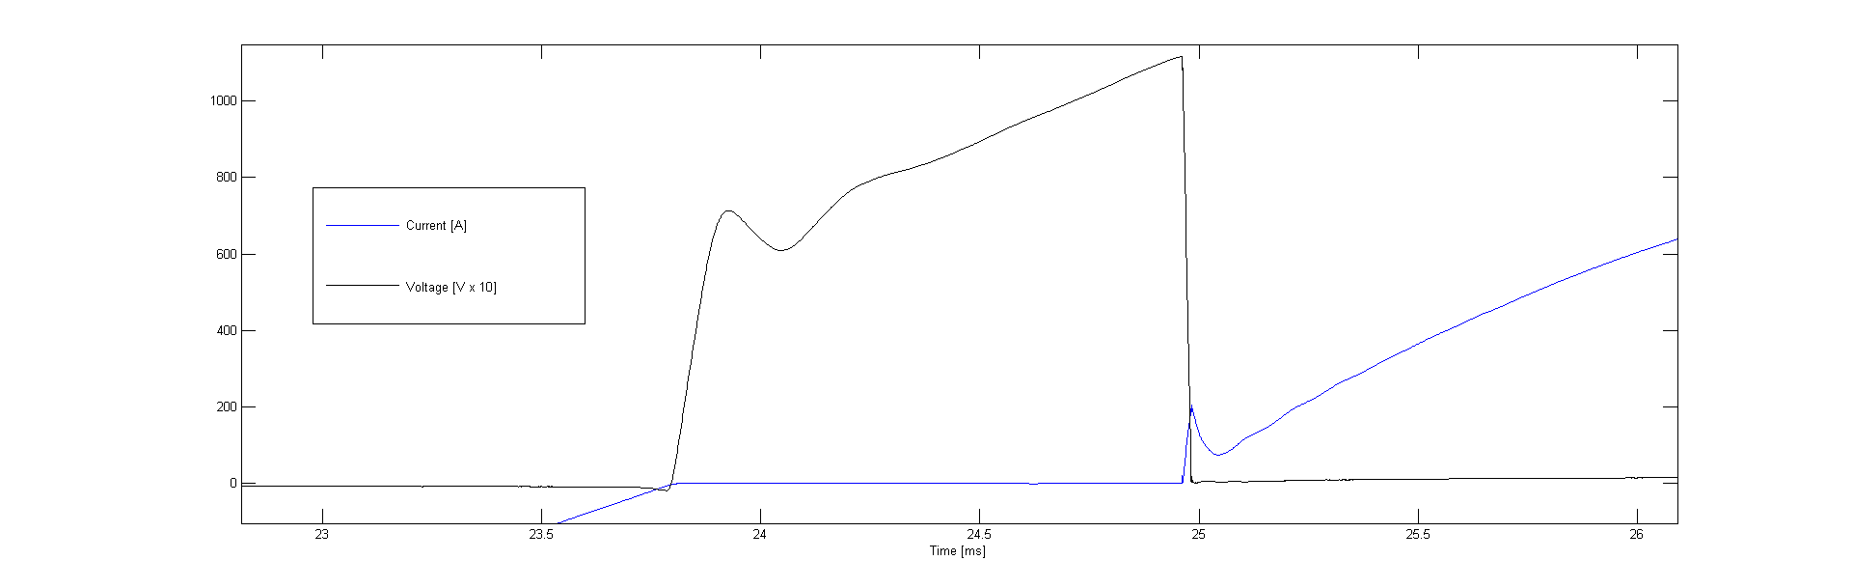
Dokument/Bilder/Results/DRplot.png
