andertei/Masteroppgave/Dokument/Bilder/Results/funnelArcDrop.PNG

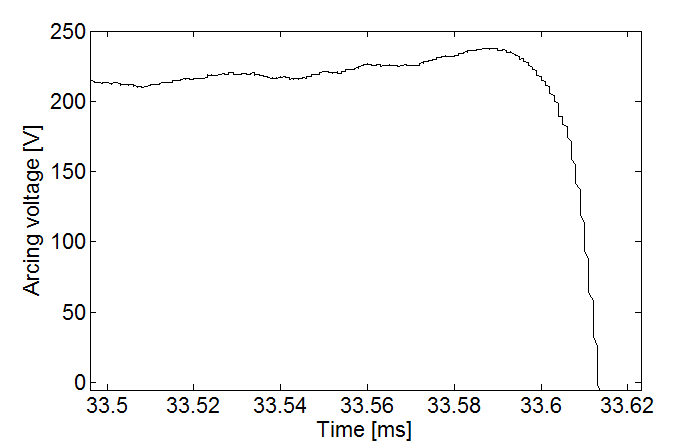
Dokument/Bilder/Results/funnelArcDrop.PNG
