andertei/Masteroppgave/Dokument/Bilder/Results/geoA630amp.PNG

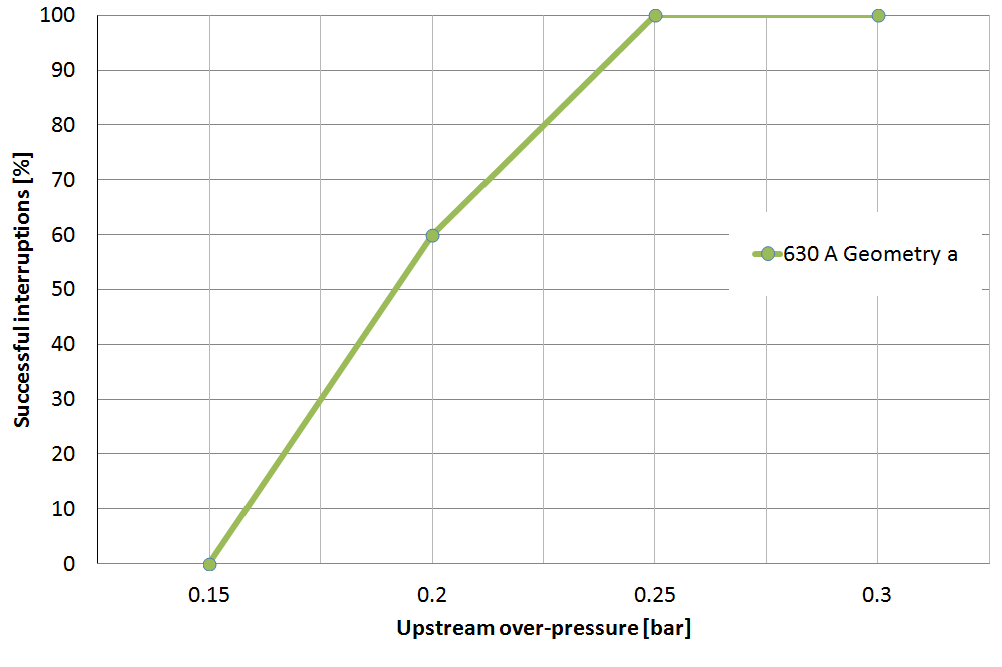
Dokument/Bilder/Results/geoA630amp.PNG
