andertei/Masteroppgave/Dokument/Bilder/Results/geoA880amp.PNG

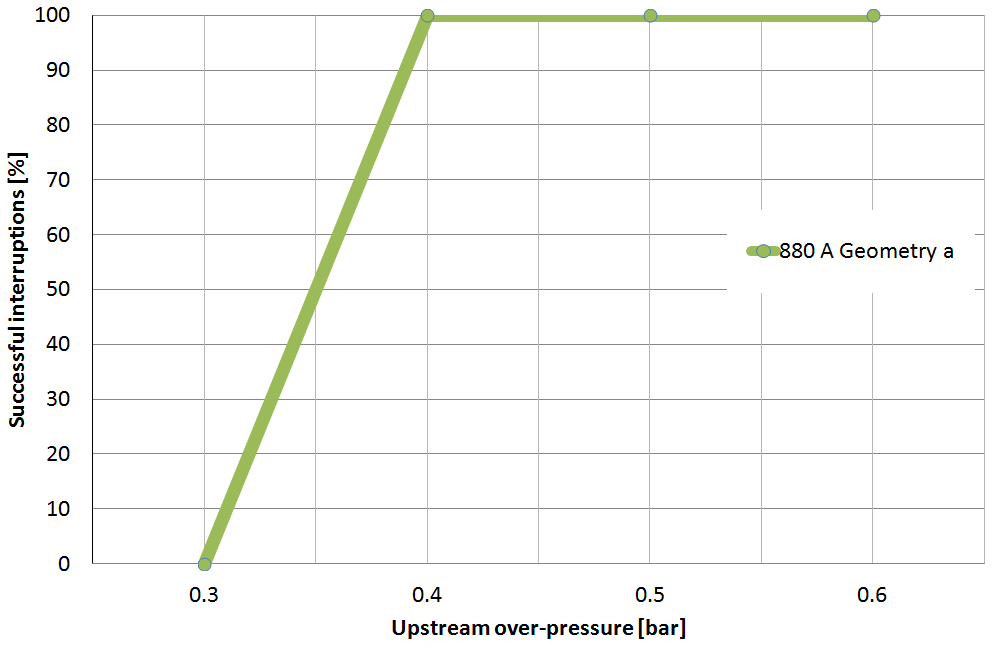
Dokument/Bilder/Results/geoA880amp.PNG
