andertei/Masteroppgave/Dokument/Bilder/Results/interruptionFlowChart.png

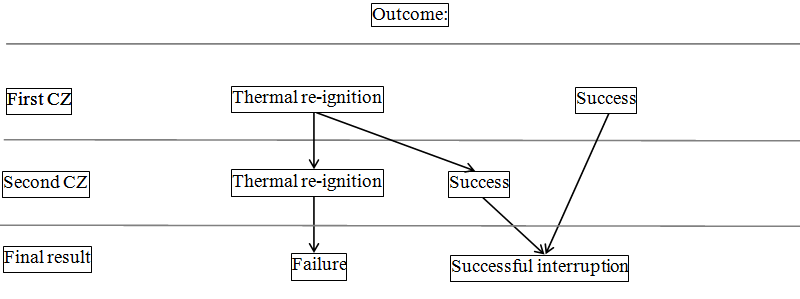
Dokument/Bilder/Results/interruptionFlowChart.png
