andertei/Masteroppgave/Dokument/Bilder/Results/outcomeinterruptionResults.png

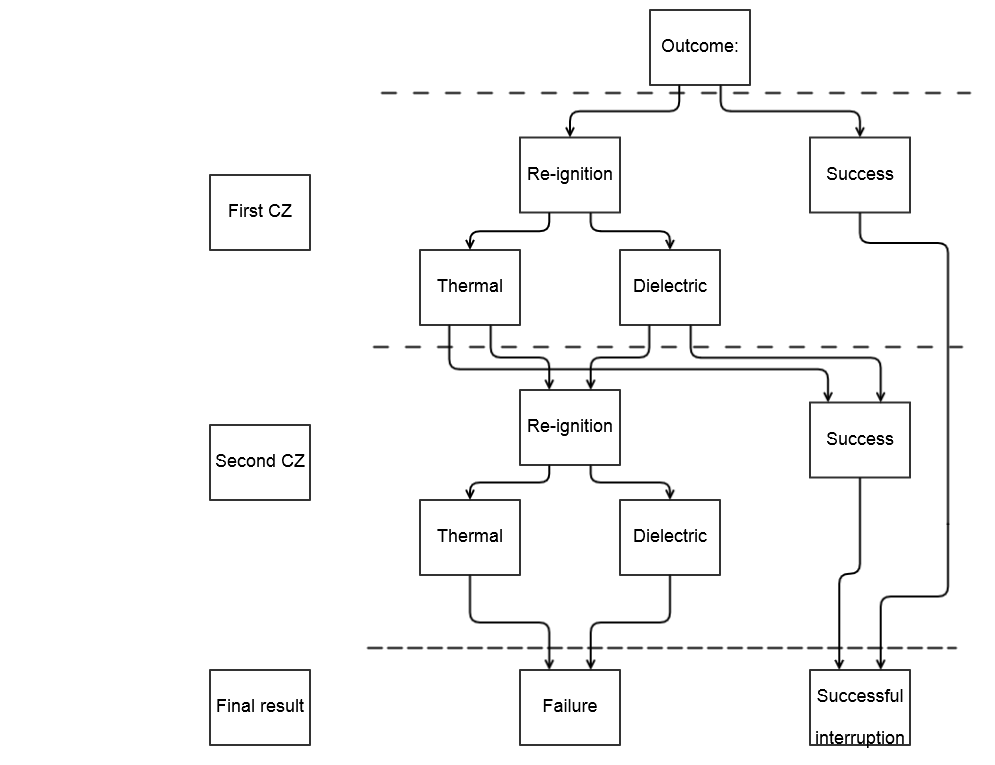
Dokument/Bilder/Results/outcomeinterruptionResults.png
