andertei/Masteroppgave/Dokument/Bilder/Results/pressureVSAcontact1.png

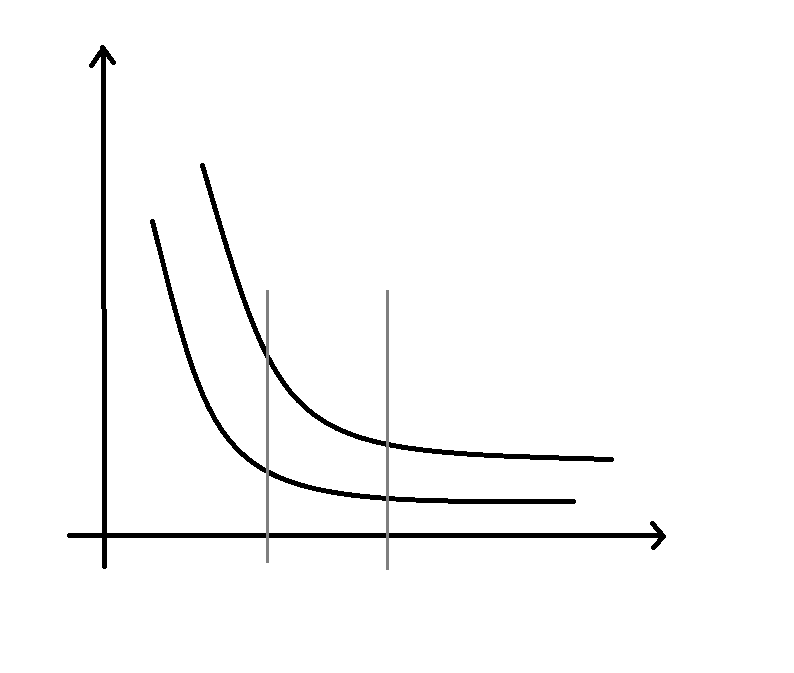
Dokument/Bilder/Results/pressureVSAcontact1.png
