andertei/Masteroppgave/Dokument/Bilder/Results/rawData400AgeoA.png

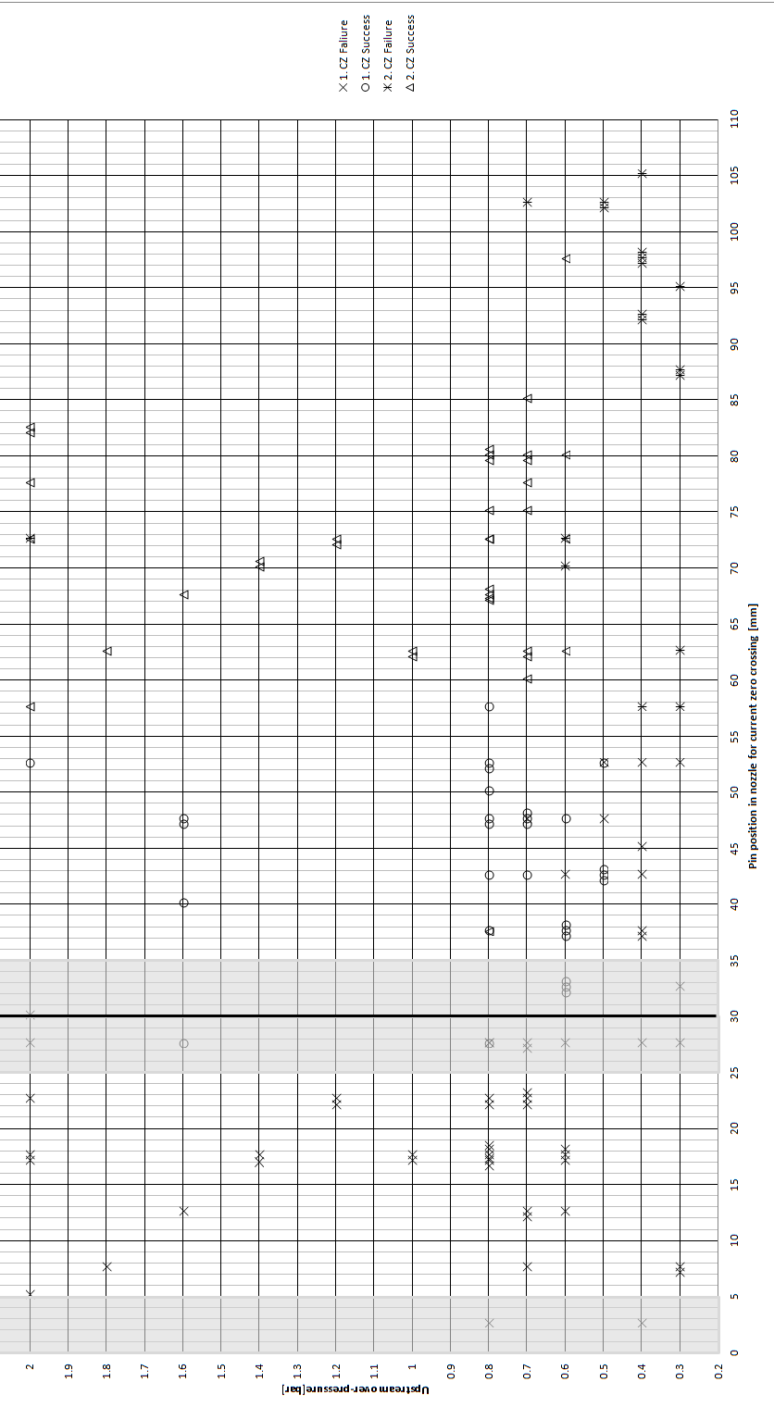
Dokument/Bilder/Results/rawData400AgeoA.png
