andertei/Masteroppgave/Dokument/Bilder/Results/rawData400AgeoB.png

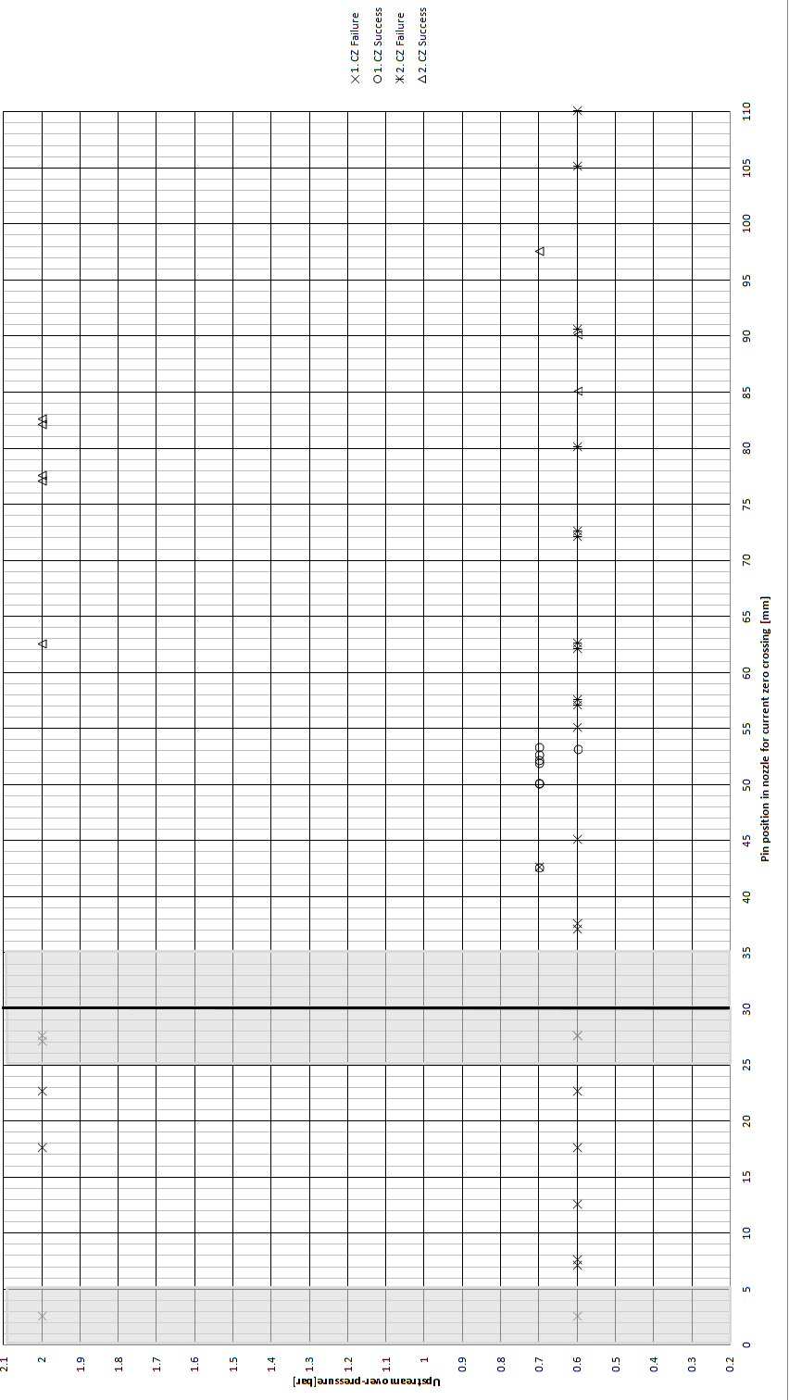
Dokument/Bilder/Results/rawData400AgeoB.png
