andertei/Masteroppgave/Dokument/Bilder/Results/rawData630AgeoA.png

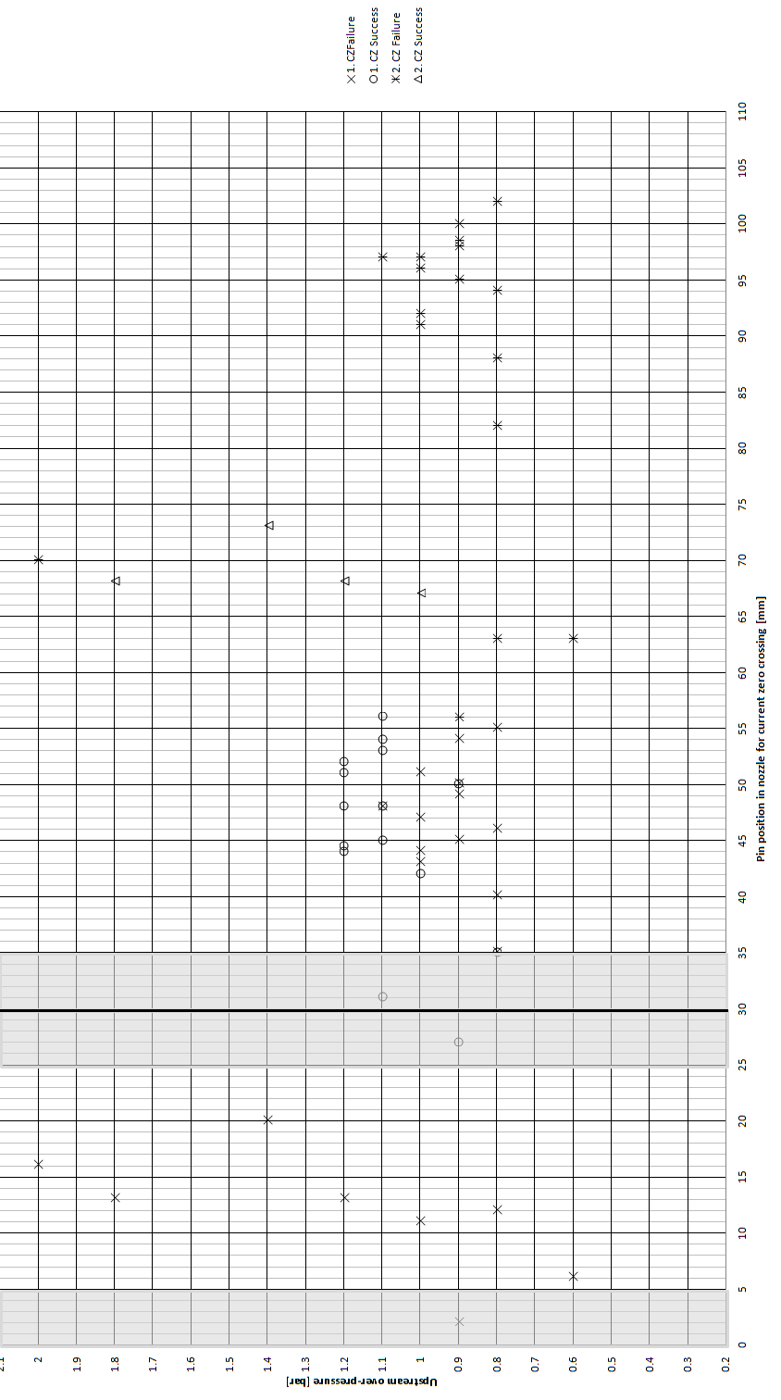
Dokument/Bilder/Results/rawData630AgeoA.png
