andertei/Masteroppgave/Dokument/Bilder/Results/rawData630AgeoB.png

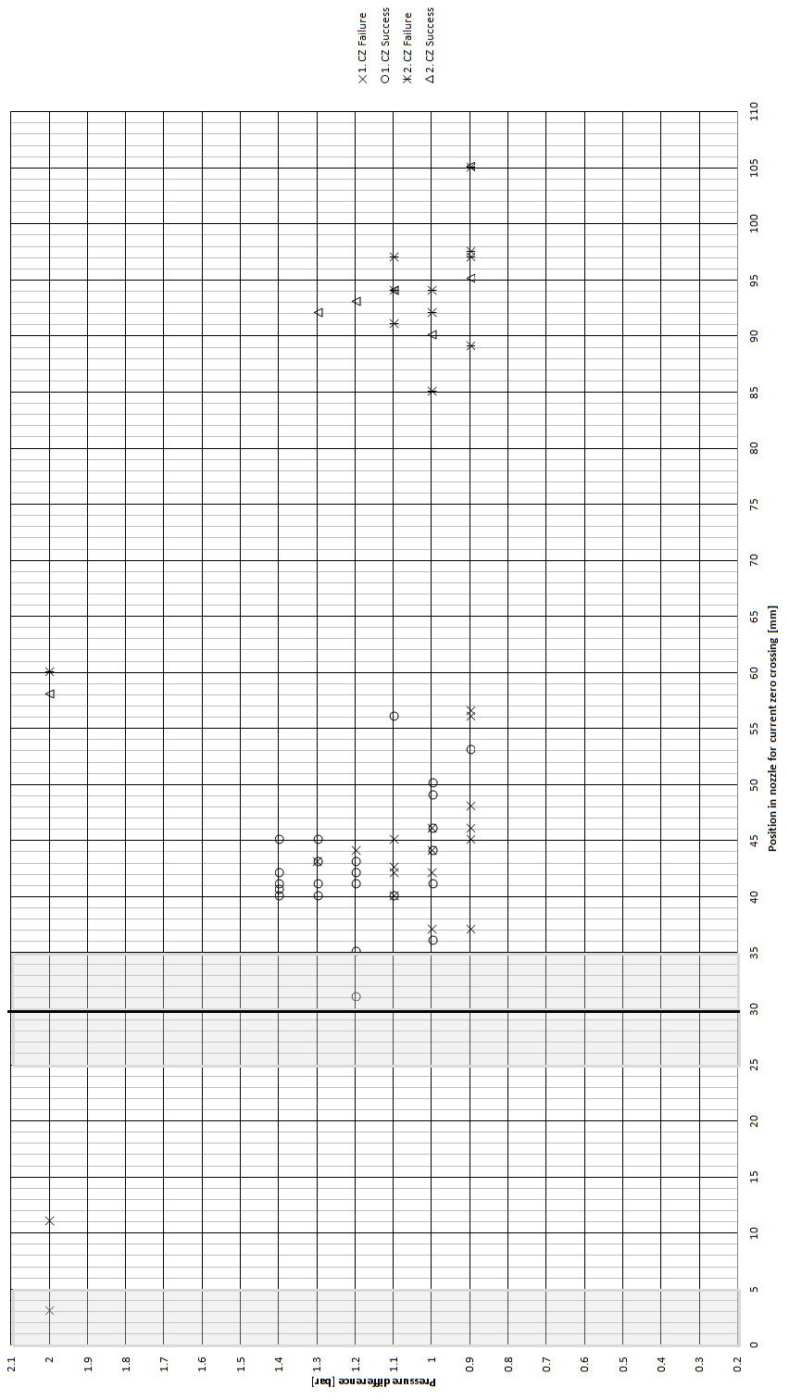
Dokument/Bilder/Results/rawData630AgeoB.png
