andertei/Masteroppgave/Dokument/Bilder/Results/successRate400A.png

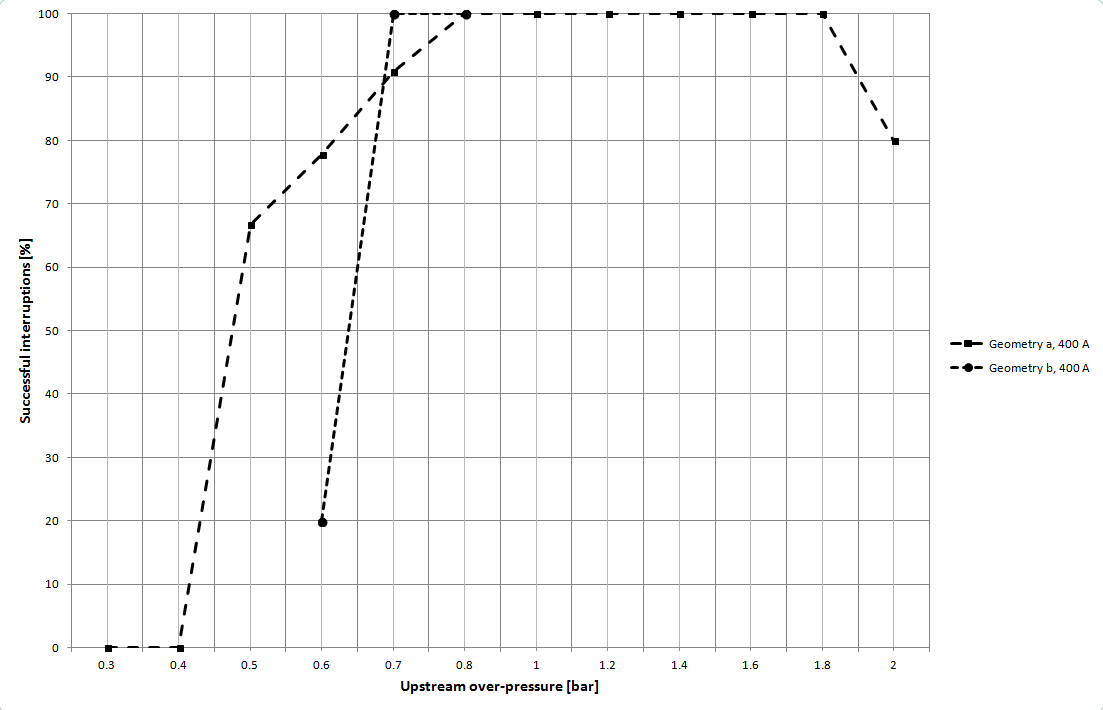
Dokument/Bilder/Results/successRate400A.png
