andertei/Masteroppgave/Dokument/Bilder/Results/successRate630A.png

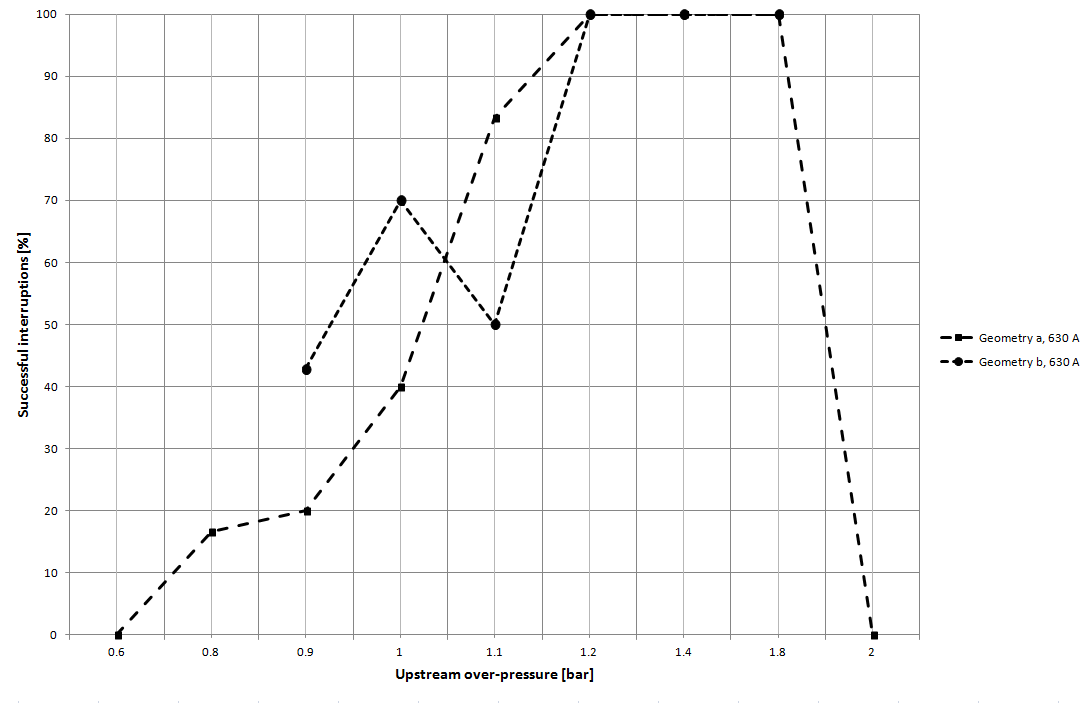
Dokument/Bilder/Results/successRate630A.png
