andertei/Masteroppgave/Dokument/Bilder/Results/test_voltage_1.PNG

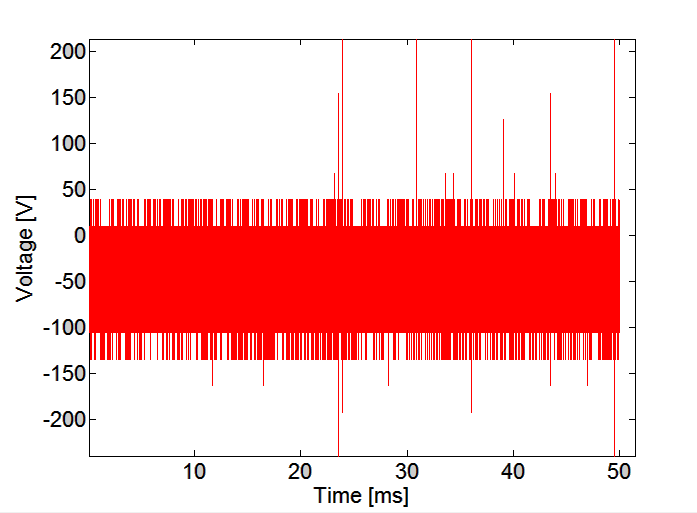
Dokument/Bilder/Results/test_voltage_1.PNG
