andertei/Masteroppgave/Dokument/Bilder/Results/test_voltage_2.PNG

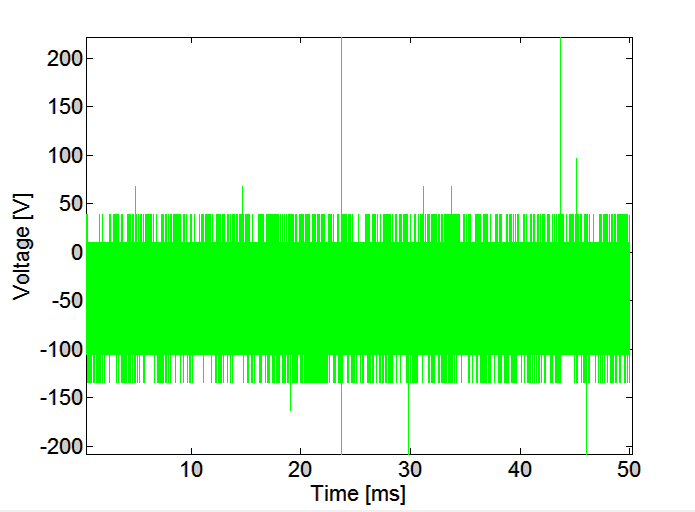
Dokument/Bilder/Results/test_voltage_2.PNG
