andertei/Masteroppgave/Dokument/Bilder/Theory/SchematicTestSwitch.png

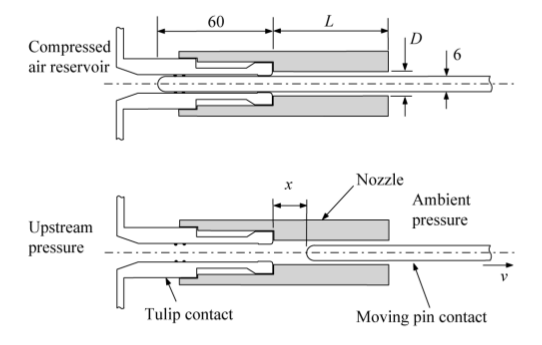
Dokument/Bilder/Theory/SchematicTestSwitch.png
