andertei/Masteroppgave/(commit log)

2014-02-03 CAD NozzleContact
    [#contactGeometry.dxf, contactGeometry.dxf]
2014-02-03 contact funnel and shape bilde
    [##contactGeometry.dxf, contactGeometry2.dxf]
2014-02-04 bilde def areal
    [#contactGeometry_areaDeff.dxf, contactGeometry_areaDeff.dxf]
2014-02-06 switchgear design and operation
2014-02-10 puffer kap. første utkast og ledeevne.
2014-02-11 litt retting utkast heat transport
2014-02-14 static arcing voltage intro
2014-02-14 bilder av test og average arcing voltage
2014-02-14 static arcing voltage ferdig
2014-02-15 retting Anja frem til heat
2014-02-17 dynamic arcing voltage påstartet
2014-02-18 laget ferdig bilde arcing voltage mot current. Skriv om det imorgen.
2014-02-20 rettlest arcing voltage
2014-02-25 Anja rett, heat dist.
2014-02-25 arcing voltage Anja
2014-03-05 retting air flow
2014-03-07 Nina rettet air flow considerations
2014-03-13 heat rettet mange
2014-03-14 magne static arc voltage
2014-03-14 dynamic voltage magne
2014-03-14 air flow magne
2014-03-28 resultater 630A7.1mm ferdig
2014-03-29 plote av 630 A resultater
    [630Ad7.1.xlsx]
2014-03-29 oppdatering 630 A
    [630Ad7.1.xlsx]
2014-03-30 arcingoltage resultater 630 A 18mm
2014-03-30 resultater 18mm ferdig
2014-03-31 filter endring
2014-04-10 resultater første avsnitt interruption ferdig
2014-04-11 excel resultater
    [630Ad6.0.xlsx]
2014-04-12 ferdig med excel dokumenter trakt
    [630Ad6.0.xlsx]
2014-04-13 ecxcel ferdig
    [630Ad6.0.xlsx, 630Ad7.1.xlsx]
2014-04-13 første utkast interruption resultater
2014-04-13 sortert 75mm på nullpunkt bedre blir det ikke.
2014-04-13 mer pirk 75 mm sortVoltage
2014-04-14 helvetes drit oppdatering av 75mm sortvoltage
2014-04-14 mere drit på 18mm sortVoltage ferdig med møkke nå
2014-04-14 arcing voltage resul,tater skrevet
2014-04-15 førsteutkast 75 mm arcing voltage
2014-04-15 arcing voltage resultater førsteutkast ferdig
2014-04-16 små pirk arcingv voltage
2014-04-16 bildesekvens 301 og arcing voltage drop påstartet
2014-04-17 første utkast til CurrentDrop DR
2014-04-18 oppdatert resultater etter feil i geo a 630 A test
    [630Ad6.0.xlsx]
2014-04-22 litt omstrukturering
    [ny_630Ad6.0.xlsx, ny_630Ad7.1.xlsx]
2014-04-23 fjerning av et bilde, includering av et nytt DR current kap
2014-04-23 oppdatering av bilde. Husk å endre komma til . hjemme
    [ny_630Ad6.0.xlsx]
2014-04-24 DISKUSJON OG BILDER TIL DEN
    [#flowSketch.dxf, flowSketch.dxf, flowSketch_narrow.dxf, flowSketch_wide.dxf]
2014-04-25 bilder bellow
    [#bellow.dxf, bellow.dxf]
2014-05-06 første utkast interruption disk ferdig
2014-05-06 Arcing voltage påstartet
2014-05-07 første utkast til arcing voltage kap
2014-05-10 litt pirk arcing voltage starter på diskusjon imorgen
2014-05-11 arcing voltage første utkast ferdig
2014-05-11 førsteutkast steep drop arcingv voltage
2014-05-13 current drop
2014-05-13 disk arcing voltage
2014-05-14 omstokking på interruption tests disk, se imorgen
2014-05-22 1.innledning+switcharou på metode
2014-05-26 fjernet alu. som kontakt materiale siden det ikke brukes
2014-05-29 switcharuu til utf8 fra latin1
2014-05-30 funnel and cyl arc volt plottet sammen, disk oppdatert
